Parsahm86/Car-Jack-SolidWorks/RENDERS/Car-Jack-Assem/Car-Jack-Assem_Camera_SOLIDWORKS Viewport.jpg

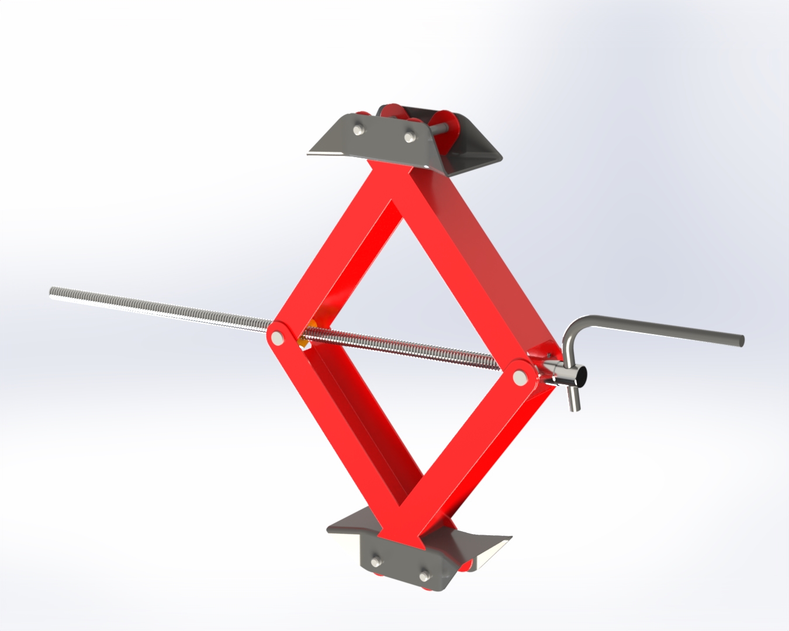
RENDERS/Car-Jack-Assem/Car-Jack-Assem_Camera_SOLIDWORKS Viewport.jpg
