Parsahm86/Car-Jack-SolidWorks/CAD/ASSEMBLY/Assem1.SLDASM

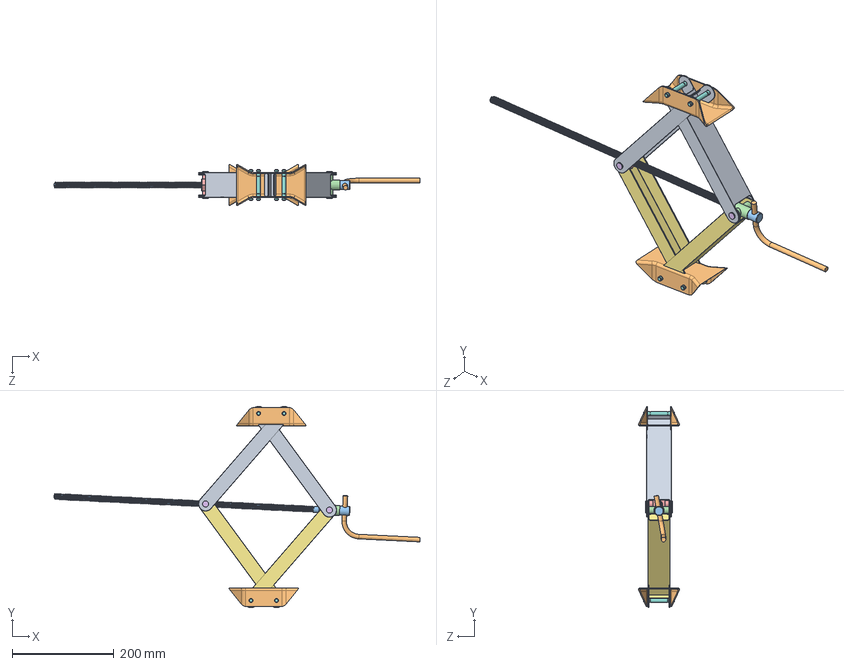
[picture p2: CAD file, 2026-08-09]
CAD/ASSEMBLY/Assem1.SLDASM
718.1 x 395.0 x 80.6 mm
Base SHeet x 2
Arm-1 x 2
Pin2 x 4
Arm-2 x 2
Pin1 x 4
Screw Nut
Screw Holder
Screw Rod
Torgue Handle
Socket set Screw x 4
