Parsahm86/Car-Jack-SolidWorks/CAD/PARTS/Pin2.SLDPRT

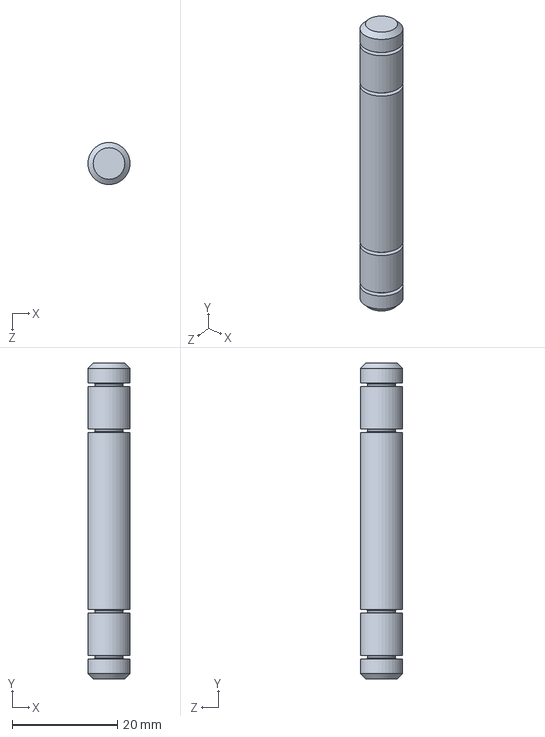
[picture p3: CAD file, 2026-08-09]
CAD/PARTS/Pin2.SLDPRT
8.00 x 60.0 x 8.00 mm
