Parsahm86/Car-Jack-SolidWorks/CAD/PARTS/Torgue Handle.SLDPRT

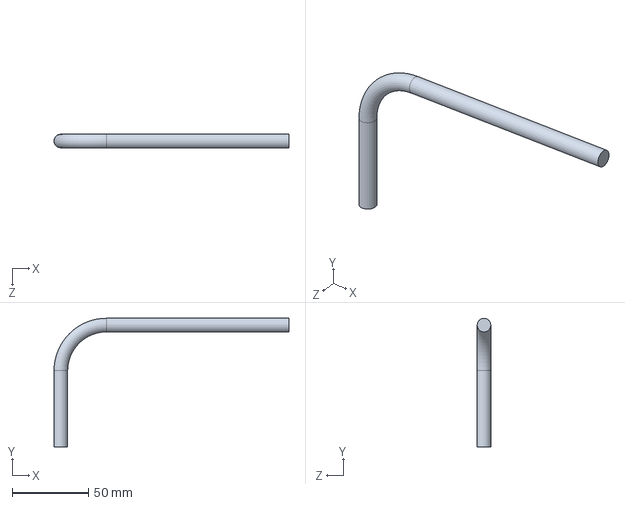
[picture p4: CAD file, 2026-08-09]
CAD/PARTS/Torgue Handle.SLDPRT
154.5 x 84.5 x 9.00 mm
