Parsahm86/Car-Jack-SolidWorks/CAD/PARTS/Pin1.SLDPRT

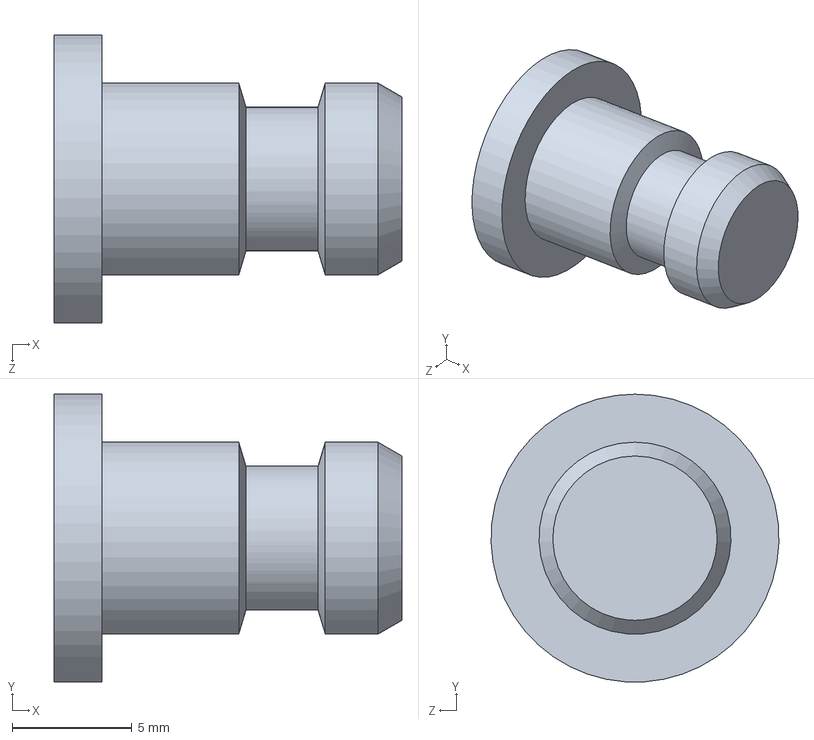
[picture p5: CAD file, 2026-08-09]
CAD/PARTS/Pin1.SLDPRT
14.5 x 12.0 x 12.0 mm
