Parsahm86/Car-Jack-SolidWorks/CAD/PARTS/Arm-2.SLDPRT

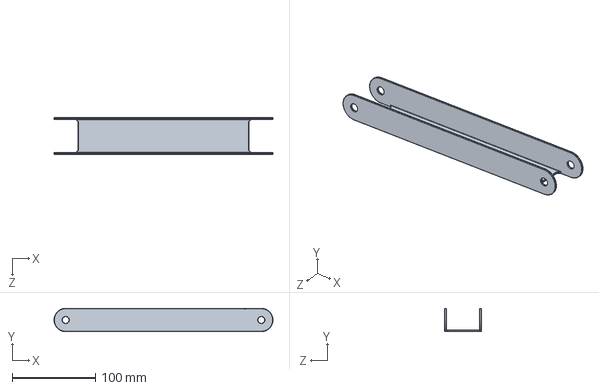
[picture p6: CAD file, 2026-08-09]
CAD/PARTS/Arm-2.SLDPRT
263.0 x 28.0 x 44.0 mm
