Parsahm86/Car-Jack-SolidWorks/CAD/PARTS/Base SHeet.SLDPRT

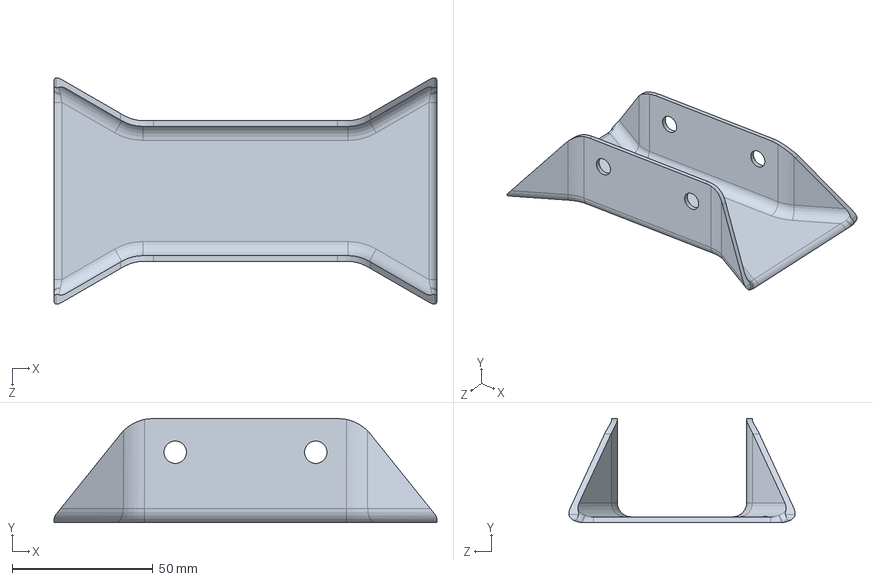
[picture p7: CAD file, 2026-08-09]
CAD/PARTS/Base SHeet.SLDPRT
136.2 x 37.0 x 80.6 mm
