Parsahm86/Car-Jack-SolidWorks/CAD/PARTS/Arm-1.SLDPRT

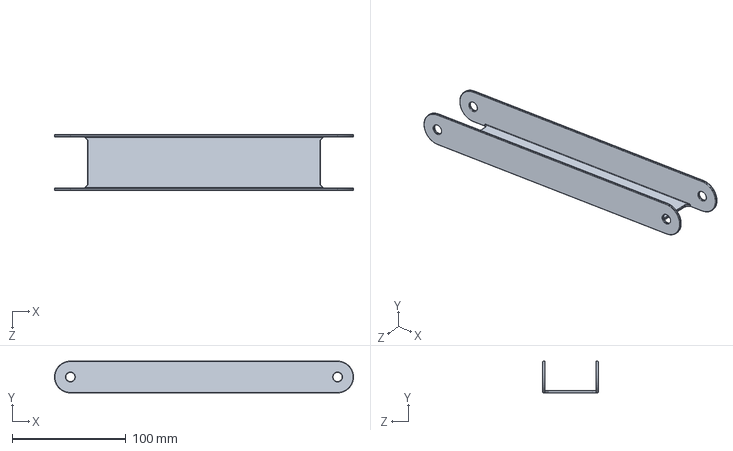
[picture p8: CAD file, 2026-08-09]
CAD/PARTS/Arm-1.SLDPRT
262.9 x 28.0 x 49.0 mm
