Parsahm86/Car-Jack-SolidWorks/CAD/PARTS/Screw Rod.SLDPRT

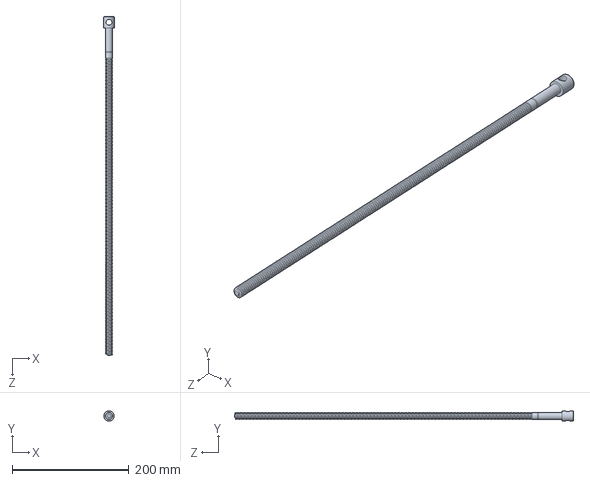
[picture p9: CAD file, 2026-08-09]
CAD/PARTS/Screw Rod.SLDPRT
18.0 x 18.0 x 581.0 mm
