Parsahm86/Car-Jack-SolidWorks/CAD/PARTS/Screw Nut.SLDPRT

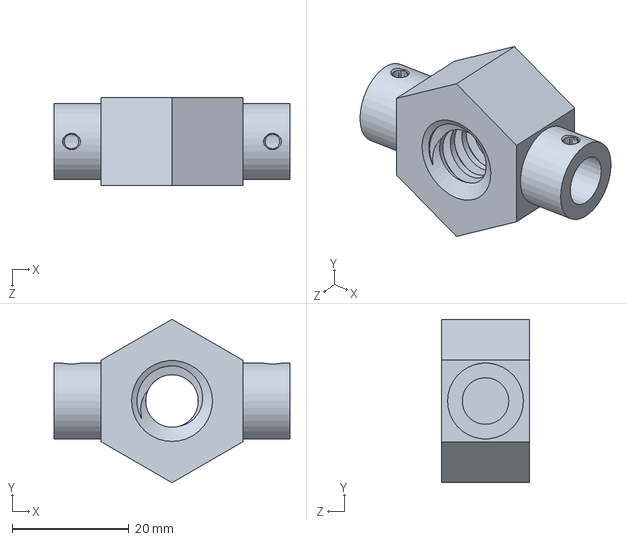
[picture p10: CAD file, 2026-08-09]
CAD/PARTS/Screw Nut.SLDPRT
40.4 x 28.0 x 15.0 mm
