Parsahm86/Car-Jack-SolidWorks/CAD/PARTS/Socket set Screw.SLDPRT

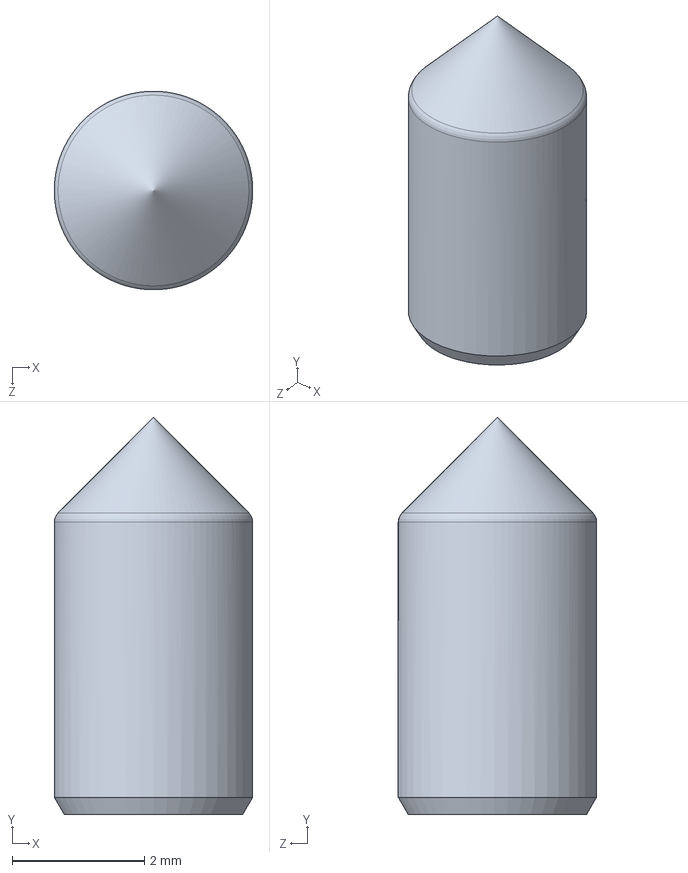
[picture p11: CAD file, 2026-08-09]
CAD/PARTS/Socket set Screw.SLDPRT
3.00 x 6.00 x 3.00 mm
