Parsahm86/Car-Jack-SolidWorks/CAD/PARTS/Screw Holder.SLDPRT

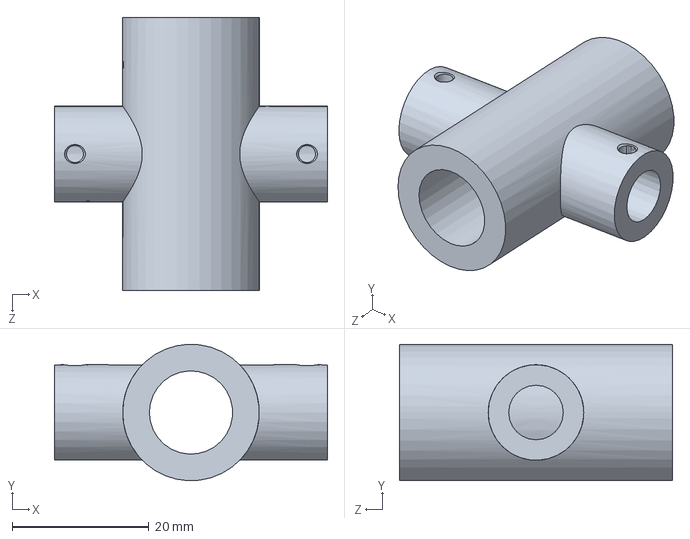
[picture p12: CAD file, 2026-08-09]
CAD/PARTS/Screw Holder.SLDPRT
40.0 x 20.0 x 40.0 mm
