Parsahm86/Car-Jack-SolidWorks/DRAWING FILES/Drawing file PDF.pdf

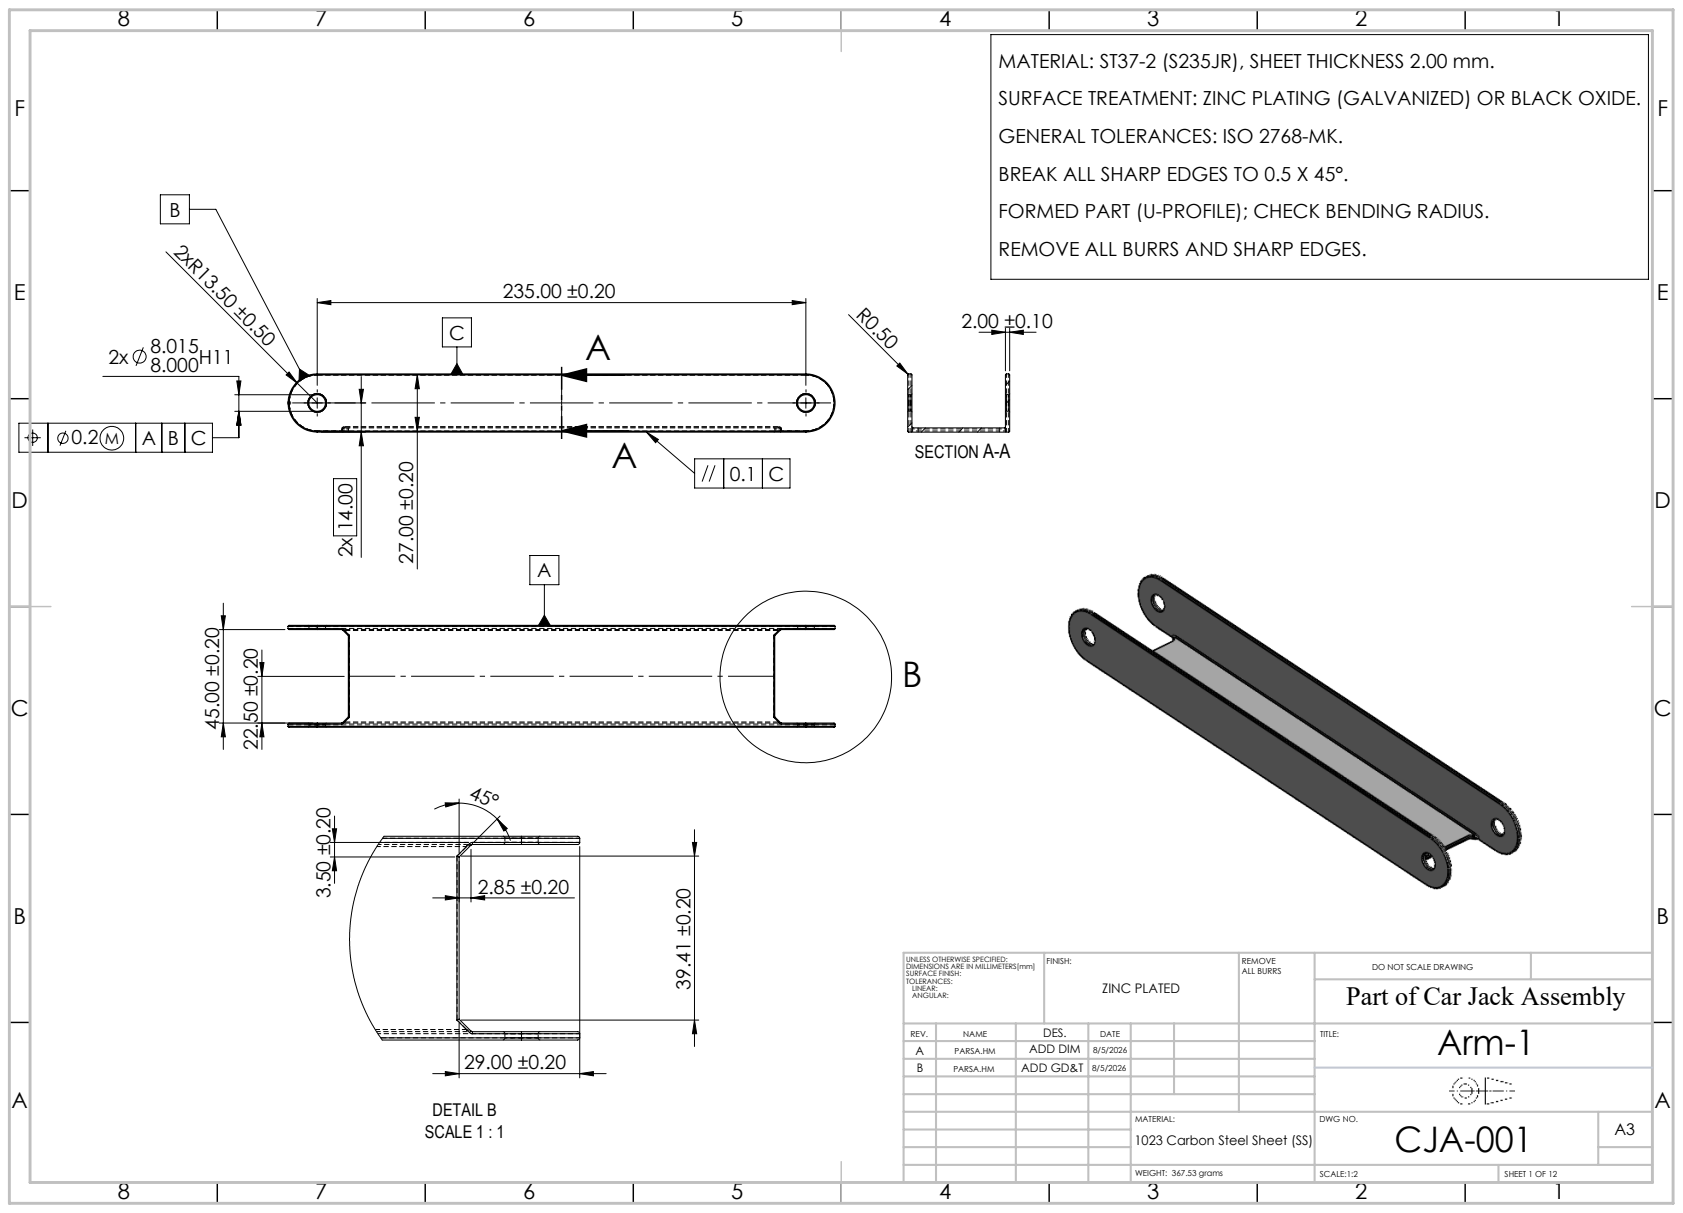
[picture p13: page 1]
SECTION A-A; DETAIL B SCALE 1 : 1; ALL BURRS; ZINC PLATED

MATERIAL: ST37-2 (S235JR), SHEET THICKNESS 2.00 mm.
SURFACE TREATMENT: ZINC PLATING (GALVANIZED) OR BLACK OXIDE.
GENERAL TOLERANCES: ISO 2768-MK.
BREAK ALL SHARP EDGES TO 0.5 X 45°.
FORMED PART (U-PROFILE); CHECK BENDING RADIUS.
REMOVE ALL BURRS AND SHARP EDGES.

UNLESS OTHERWISE SPECIFIED:
DIMENSIONS ARE IN MILLIMETERS[mm]
SURFACE FINISH:
TOLERANCES:
LINEAR:
ANGULAR:

DO NOT SCALE DRAWING
Part of Car Jack Assembly

NAME | DES. | DATE | Arm-1 REV. TITLE:
A | PARSA.HM | ADD DIM | 8/5/2026
B | PARSA.HM | ADD GD&T | 8/5/2026

MATERIAL: | DWG NO. CJA-001 | A3 1023 Carbon Steel Sheet (SS)

WEIGHT: 367.53 grams | SCALE:1:2 | SHEET 1 OF 12

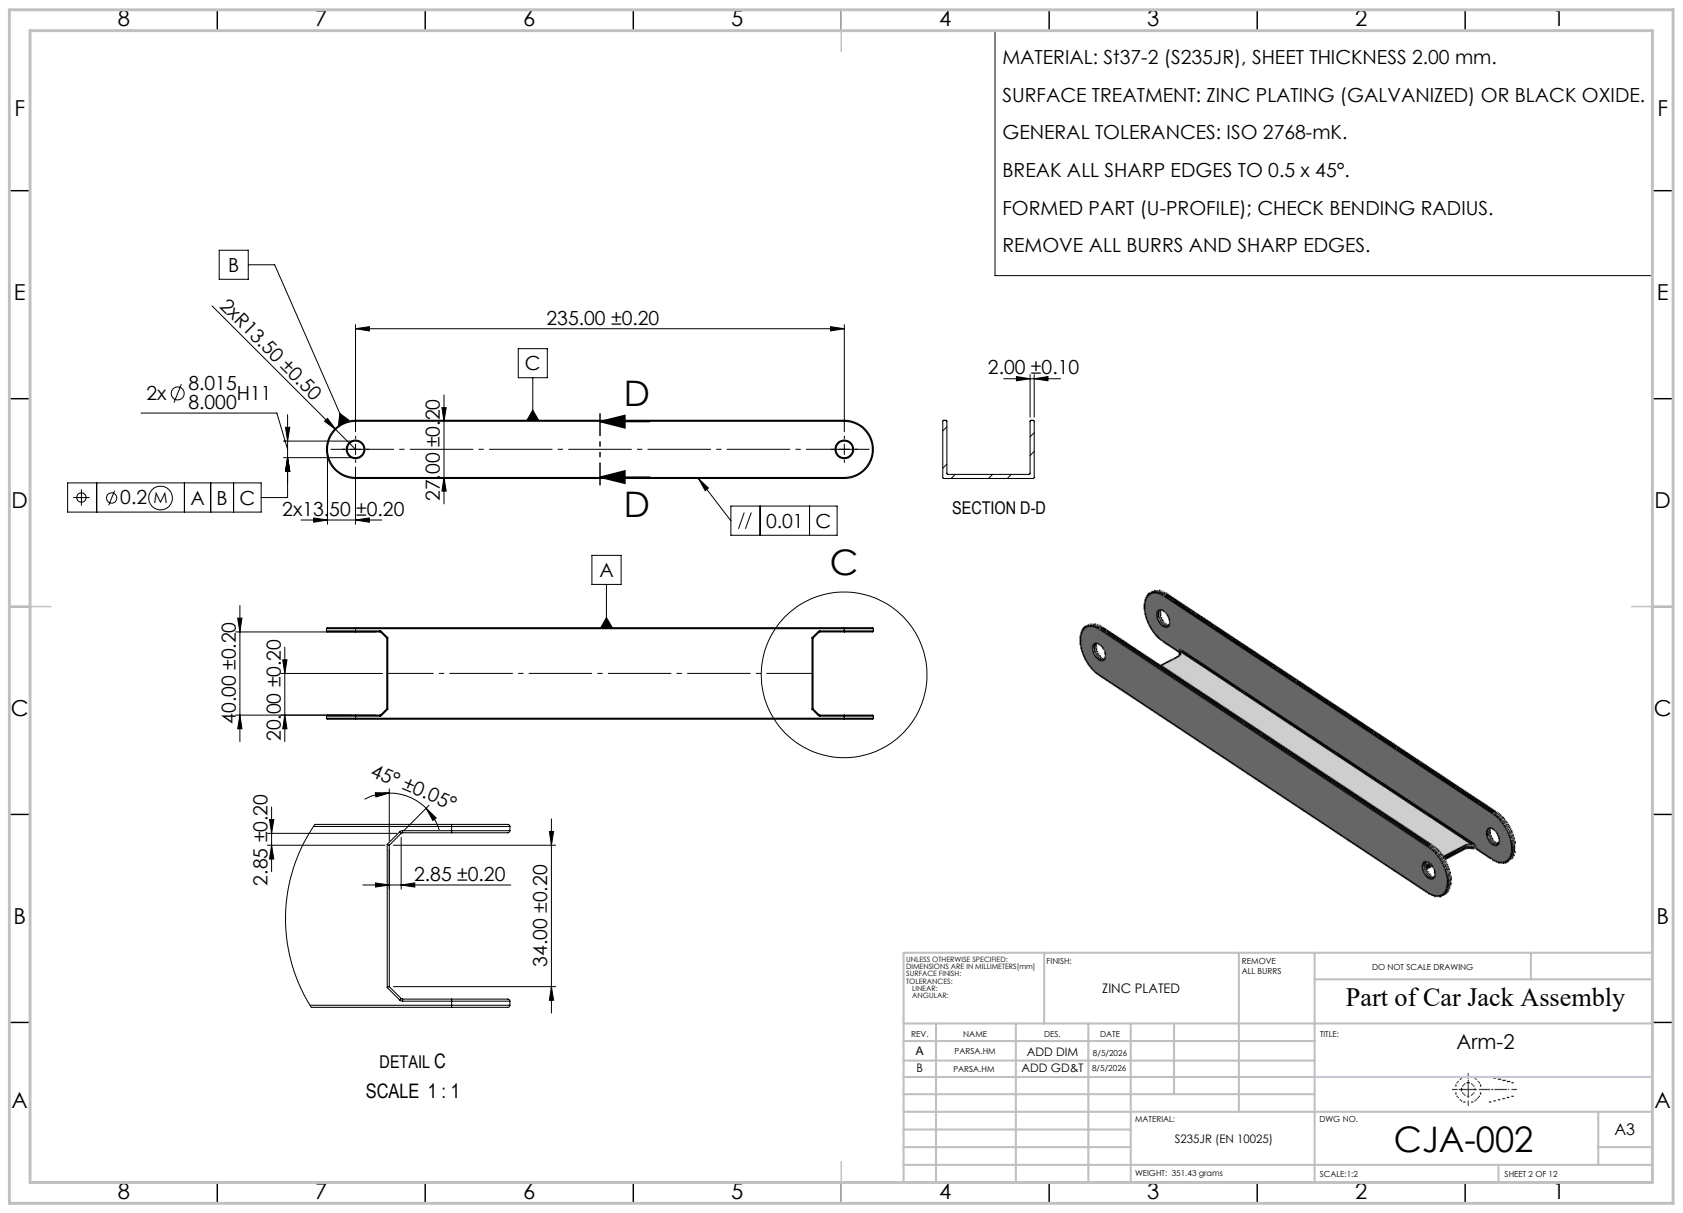
[picture p14: page 2]
DETAIL C SCALE 1 : 1; SECTION D-D; ALL BURRS; ZINC PLATED

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

UNLESS OTHERWISE SPECIFIED:
DIMENSIONS ARE IN MILLIMETERS[mm]
SURFACE FINISH:
TOLERANCES:
LINEAR:
ANGULAR:

DO NOT SCALE DRAWING
Part of Car Jack Assembly

NAME | DES. | DATE | TITLE: Arm-2 REV.
A | PARSA.HM | ADD DIM | 8/5/2026
B | PARSA.HM | ADD GD&T | 8/5/2026

CJA-002 | A3 S235JR (EN 10025)

WEIGHT: 351.43 grams | SCALE:1:2 | SHEET 2 OF 12

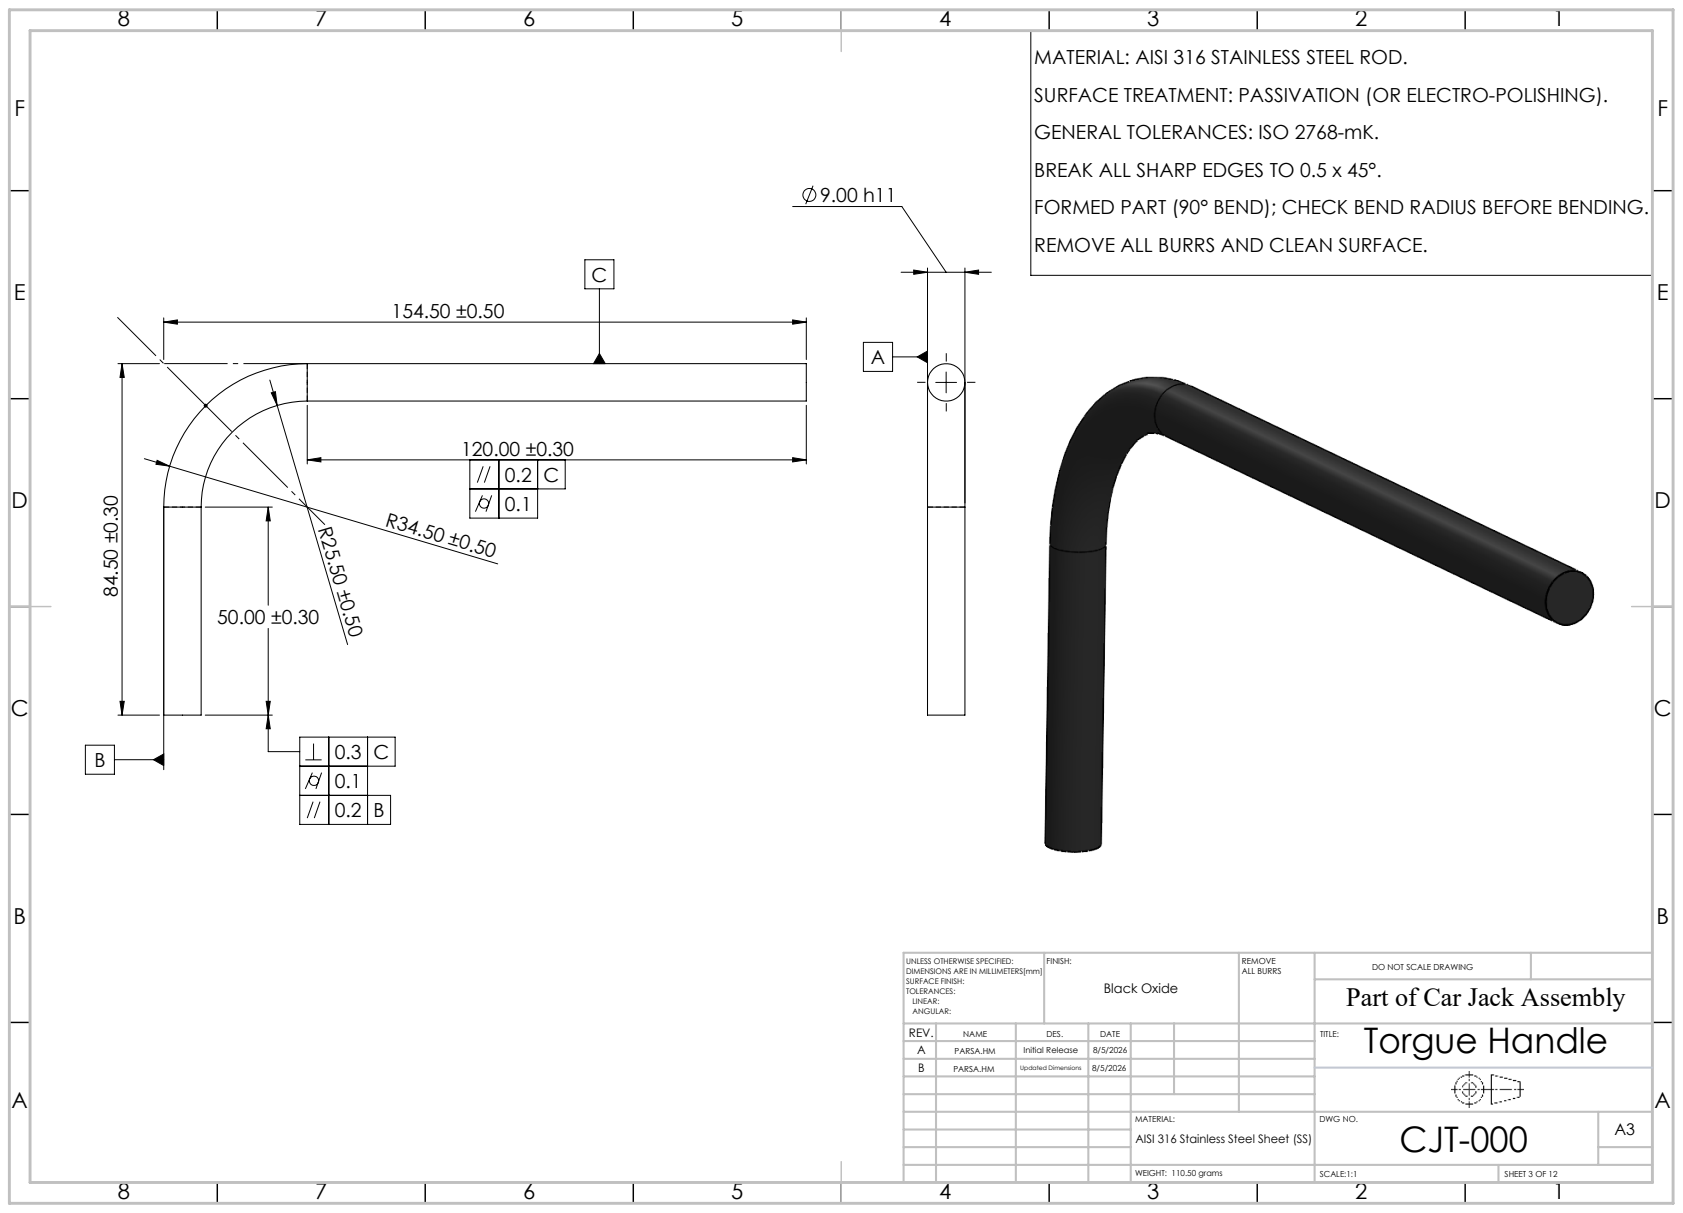
[picture p15: page 3]
ALL BURRS; Black Oxide

MATERIAL: AISI 316 STAINLESS STEEL ROD.
SURFACE TREATMENT: PASSIVATION (OR ELECTRO-POLISHING).
GENERAL TOLERANCES: ISO 2768-mK.
BREAK ALL SHARP EDGES TO 0.5 x 45°.
FORMED PART (90° BEND); CHECK BEND RADIUS BEFORE BENDING.
REMOVE ALL BURRS AND CLEAN SURFACE.

UNLESS OTHERWISE SPECIFIED:
DIMENSIONS ARE IN MILLIMETERS[mm]
SURFACE FINISH:
TOLERANCES:
LINEAR:
ANGULAR:

DO NOT SCALE DRAWING
Part of Car Jack Assembly

NAME | DES. | DATE | Torgue Handle REV. TITLE:
A | PARSA.HM | Initial Release | 8/5/2026
B | PARSA.HM | Updated Dimensions | 8/5/2026

CJT-000 | A3 AISI 316 Stainless Steel Sheet (SS)

WEIGHT: 110.50 grams | SCALE:1:1 | SHEET 3 OF 12

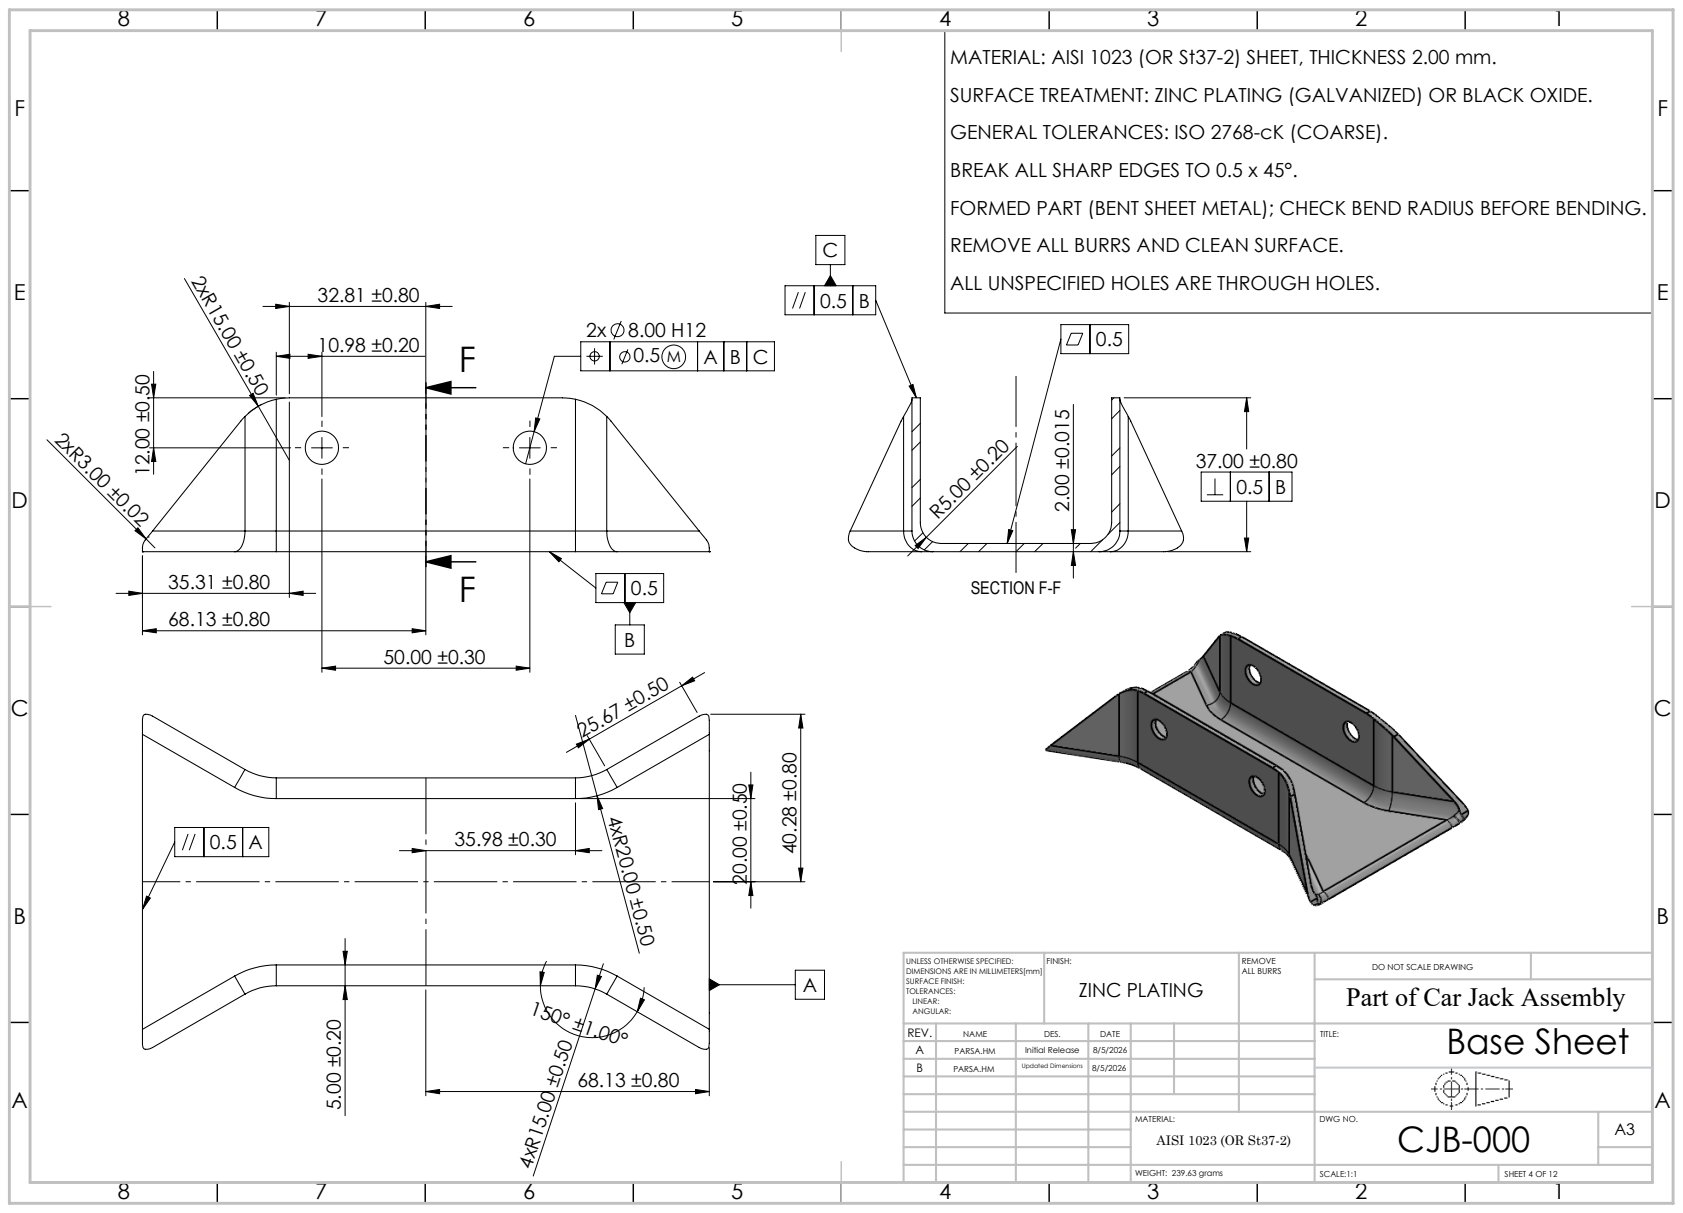
[picture p16: page 4]
SECTION F-F; ALL BURRS; ZINC PLATING

MATERIAL: AISI 1023 (OR St37-2) SHEET, THICKNESS 2.00 mm.
SURFACE TREATMENT: ZINC PLATING (GALVANIZED) OR BLACK OXIDE.
GENERAL TOLERANCES: ISO 2768-cK (COARSE).
BREAK ALL SHARP EDGES TO 0.5 x 45°.
FORMED PART (BENT SHEET METAL); CHECK BEND RADIUS BEFORE BENDING.
REMOVE ALL BURRS AND CLEAN SURFACE.
ALL UNSPECIFIED HOLES ARE THROUGH HOLES.

UNLESS OTHERWISE SPECIFIED:
DIMENSIONS ARE IN MILLIMETERS[mm]
SURFACE FINISH:
TOLERANCES:
LINEAR:
ANGULAR:

DO NOT SCALE DRAWING
Part of Car Jack Assembly

NAME | Initial Release DES. | DATE | Base Sheet REV. TITLE:
A | PARSA.HM | | 8/5/2026
B | PARSA.HM | Updated Dimensions | 8/5/2026

CJB-000 | A3 AISI 1023 (OR St37-2)

WEIGHT: 239.63 grams | SCALE:1:1 | SHEET 4 OF 12

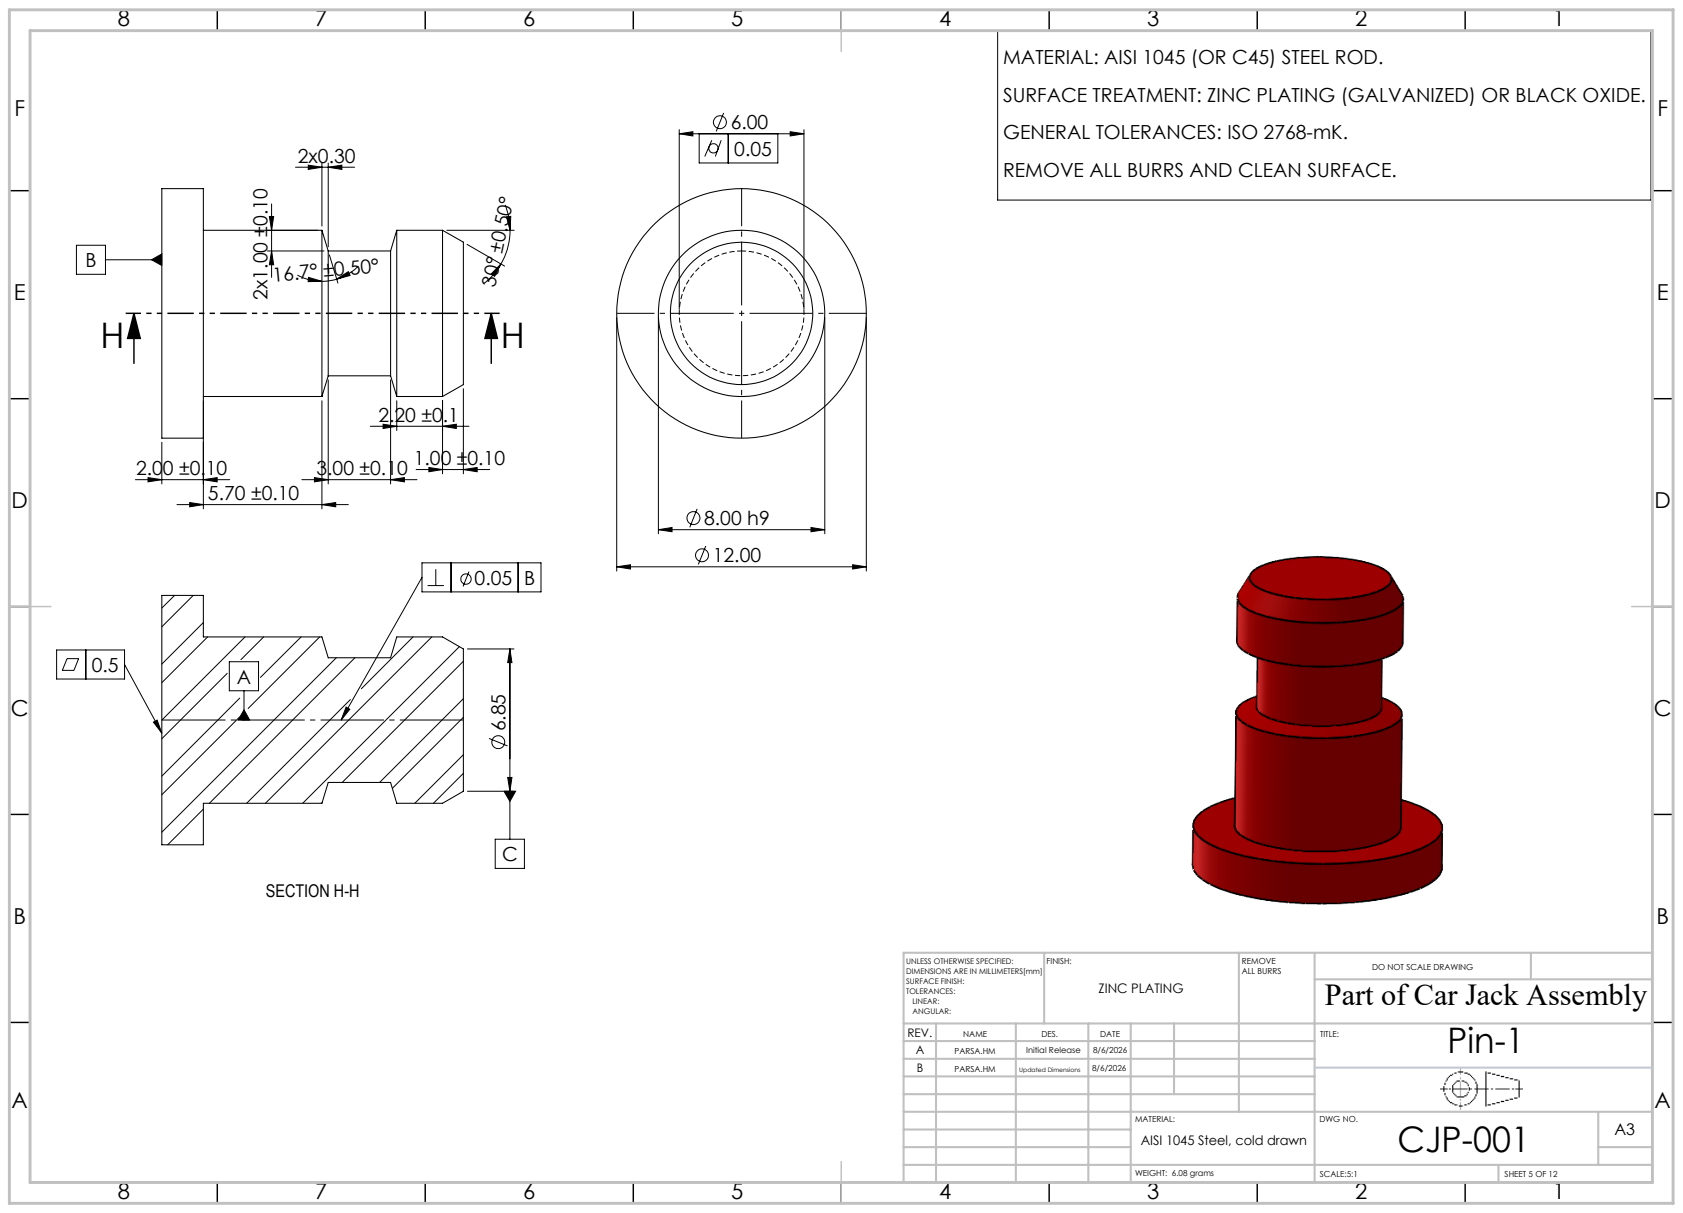
[picture p17: page 5]
SECTION H-H; ALL BURRS; ZINC PLATING

MATERIAL: AISI 1045 (OR C45) STEEL ROD.
SURFACE TREATMENT: ZINC PLATING (GALVANIZED) OR BLACK OXIDE.
GENERAL TOLERANCES: ISO 2768-mK.
REMOVE ALL BURRS AND CLEAN SURFACE.

UNLESS OTHERWISE SPECIFIED:
DIMENSIONS ARE IN MILLIMETERS[mm]
SURFACE FINISH:
TOLERANCES:
LINEAR:
ANGULAR:

DO NOT SCALE DRAWING
Part of Car Jack Assembly

NAME | DES. | DATE | Pin-1 REV. TITLE:
A | PARSA.HM | Initial Release | 8/6/2026
B | PARSA.HM | Updated Dimensions | 8/6/2026

CJP-001 | A3 AISI 1045 Steel, cold drawn

WEIGHT: 6.08 grams | SCALE:5:1 | SHEET 5 OF 12

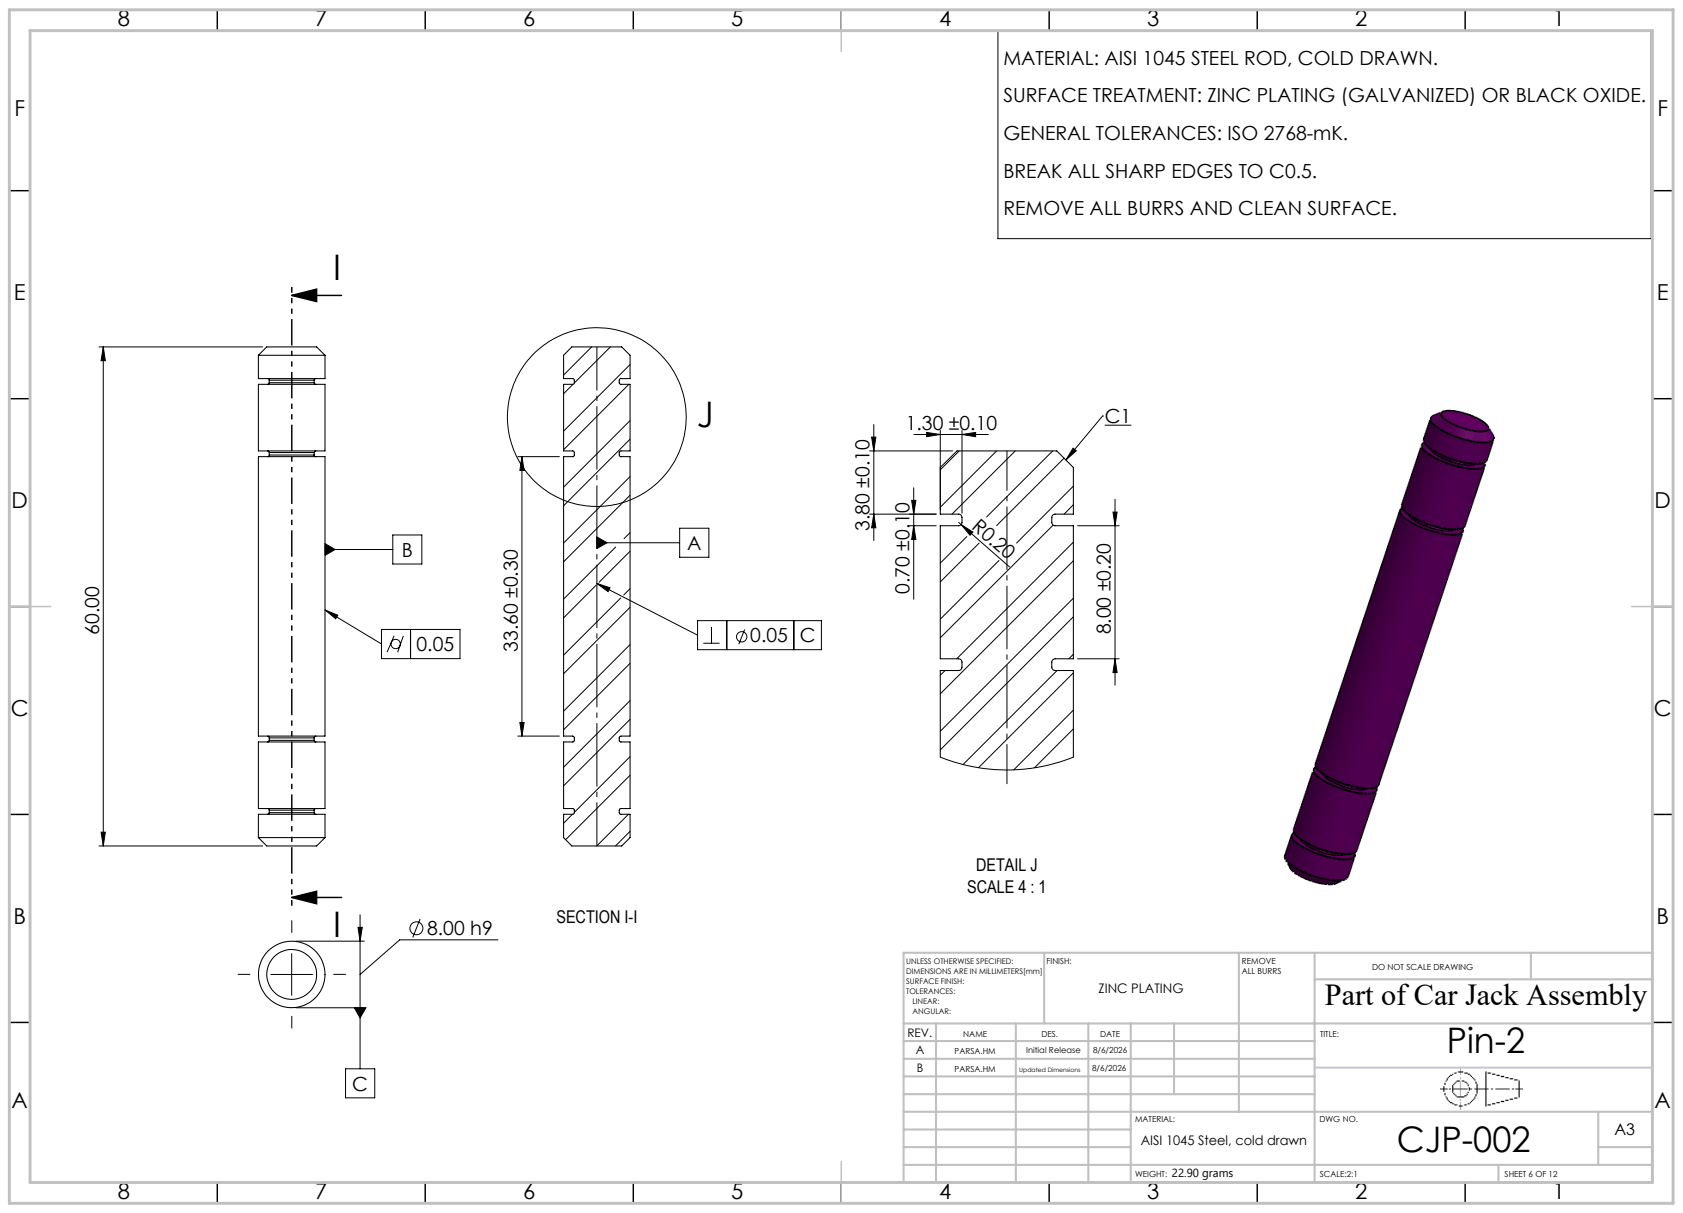
[picture p18: page 6]
SECTION I-I; DETAIL J SCALE 4 : 1; ALL BURRS; ZINC PLATING

MATERIAL: AISI 1045 STEEL ROD, COLD DRAWN.
SURFACE TREATMENT: ZINC PLATING (GALVANIZED) OR BLACK OXIDE.
GENERAL TOLERANCES: ISO 2768-mK.
BREAK ALL SHARP EDGES TO C0.5.
REMOVE ALL BURRS AND CLEAN SURFACE.

UNLESS OTHERWISE SPECIFIED:
DIMENSIONS ARE IN MILLIMETERS[mm]
SURFACE FINISH:
TOLERANCES:
LINEAR:
ANGULAR:

DO NOT SCALE DRAWING
Part of Car Jack Assembly

NAME | DES. | DATE | Pin-2 REV. TITLE:
A | PARSA.HM | Initial Release | 8/6/2026
B | PARSA.HM | Updated Dimensions | 8/6/2026

CJP-002

WEIGHT: 22.90 grams | SCALE:2:1 | SHEET 6 OF 12

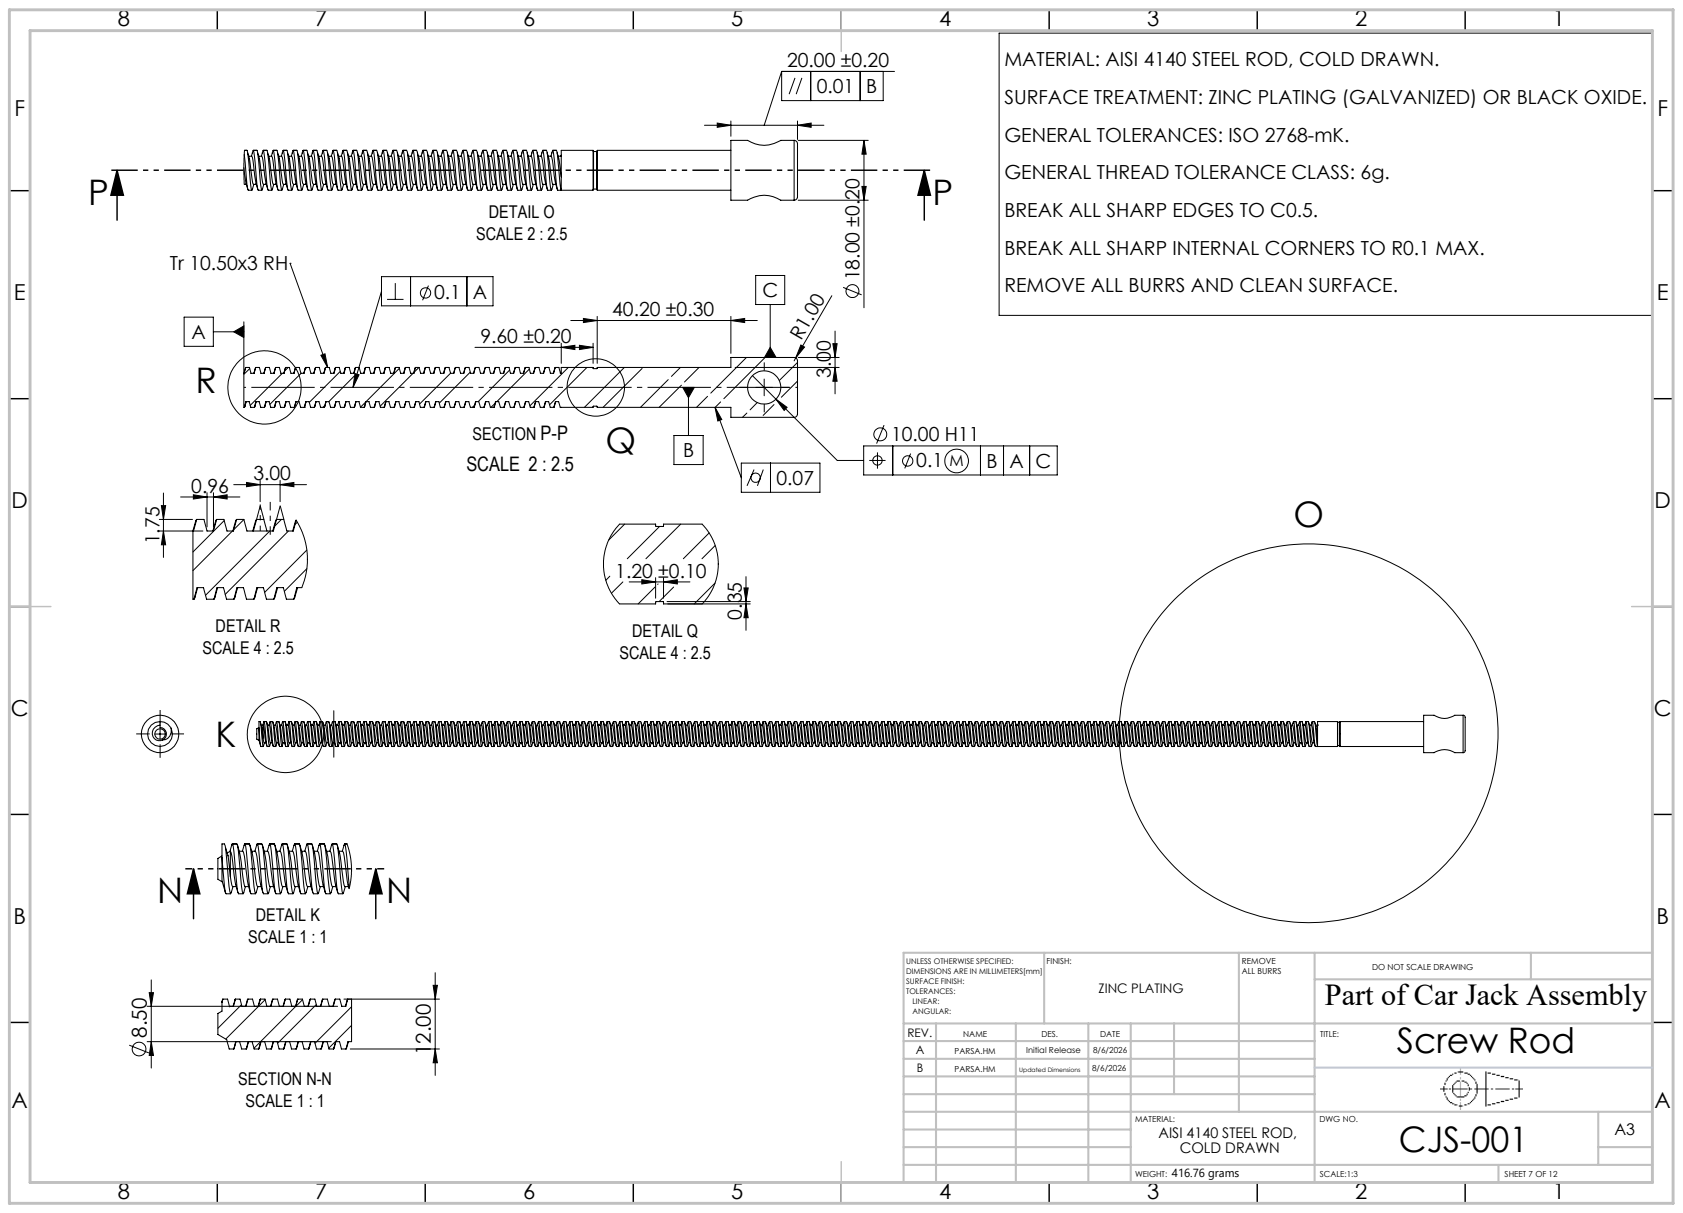
[picture p19: page 7]
DETAIL K SCALE 1 : 1; SECTION N-N SCALE 1 : 1; DETAIL O SCALE 2 : 2.5; SECTION P-P SCALE 2 : 2.5; DETAIL Q SCALE 4 : 2.5; DETAIL R SCALE 4 : 2.5; ALL BURRS; SCALE:1:3; SHEET 7 OF 12; AISI 4140 STEEL ROD,; COLD DRAWN; ZINC PLATING; WEIGHT: 416.76 grams; Initial Release; Updated Dimensions

MATERIAL: AISI 4140 STEEL ROD, COLD DRAWN.

SURFACE TREATMENT: ZINC PLATING (GALVANIZED) OR BLACK OXIDE.
GENERAL TOLERANCES: ISO 2768-mK.
GENERAL THREAD TOLERANCE CLASS: 6g.
BREAK ALL SHARP EDGES TO C0.5.
BREAK ALL SHARP INTERNAL CORNERS TO R0.1 MAX.
REMOVE ALL BURRS AND CLEAN SURFACE.

UNLESS OTHERWISE SPECIFIED:
DIMENSIONS ARE IN MILLIMETERS[mm]
SURFACE FINISH:
TOLERANCES:
LINEAR:
ANGULAR:
Screw Rod REV.

DO NOT SCALE DRAWING
Part of Car Jack Assembly

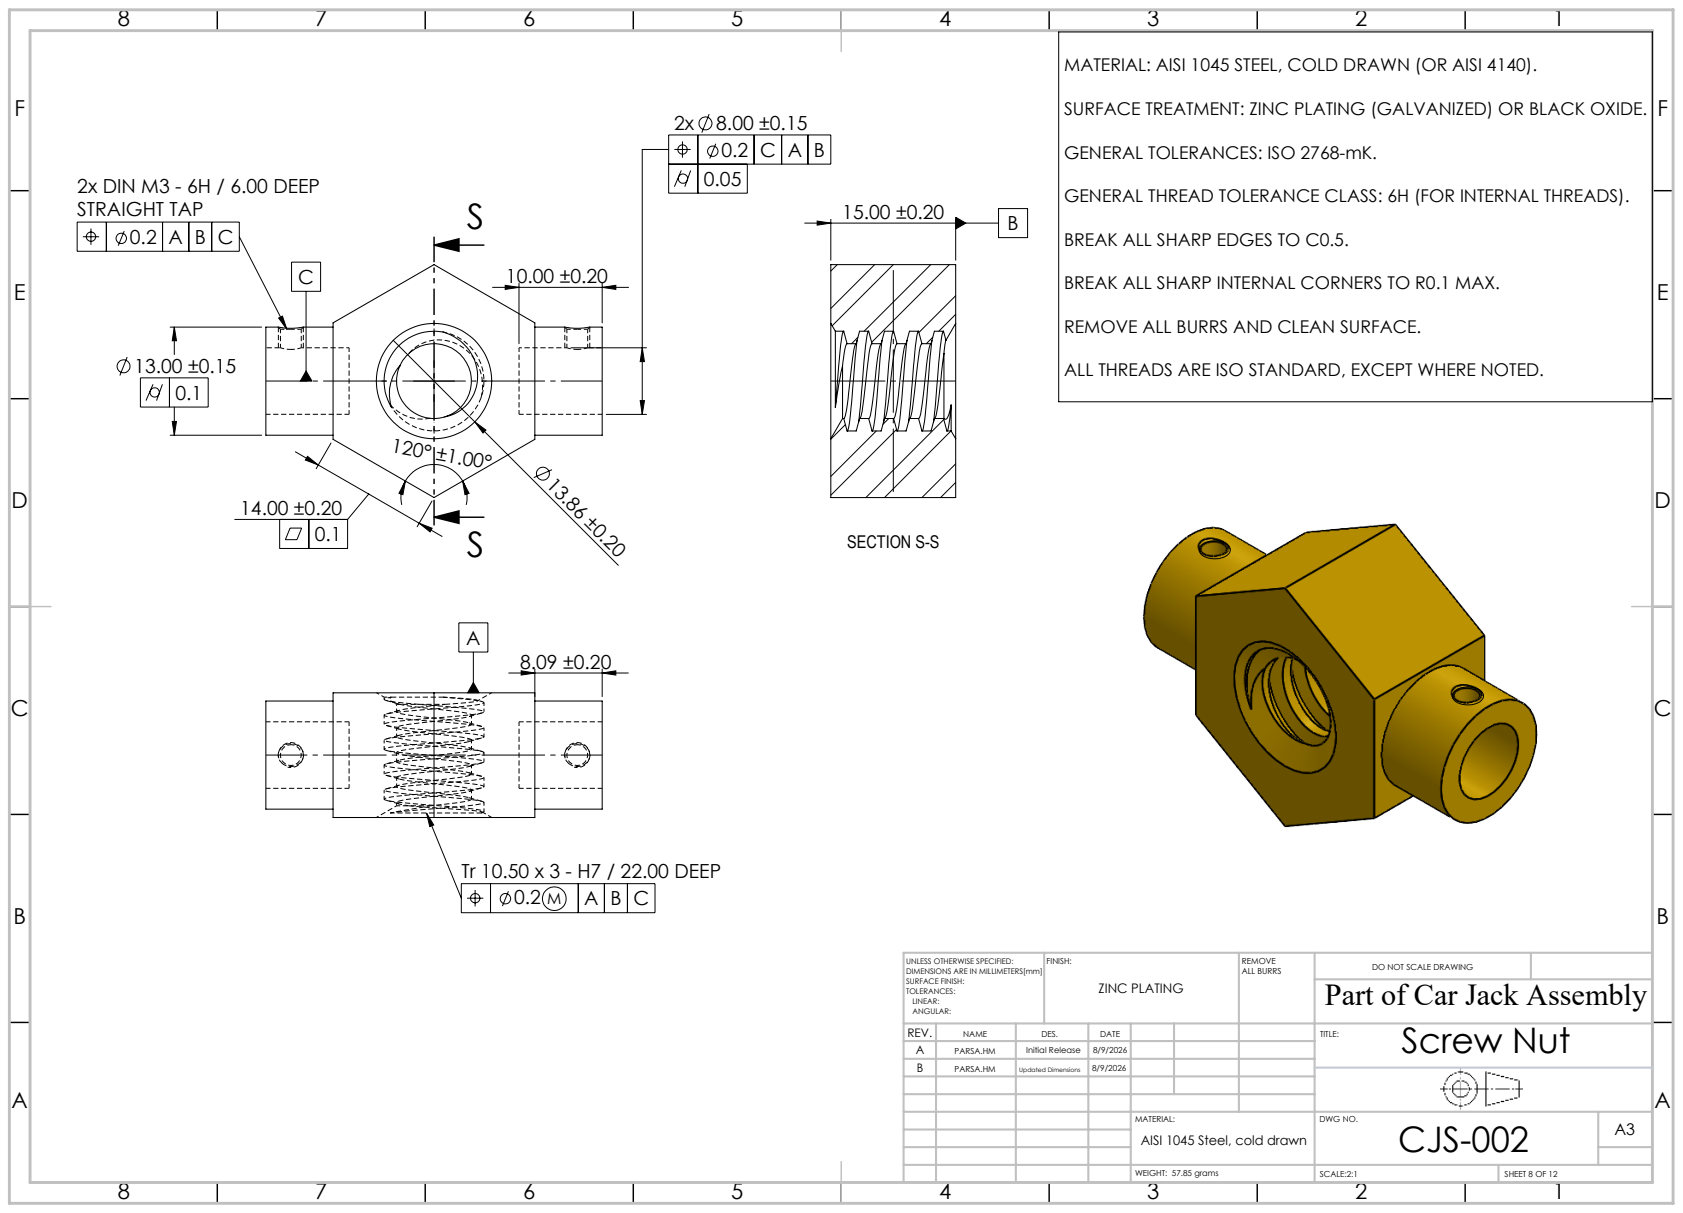
[picture p20: page 8]
2x DIN M3 - 6H / 6.00 DEEP STRAIGHT TAP; Tr 10.50 x 3 - H7 / 22.00 DEEP; SECTION S-S; ALL BURRS; ZINC PLATING

MATERIAL: AISI 1045 STEEL, COLD DRAWN (OR AISI 4140).
SURFACE TREATMENT: ZINC PLATING (GALVANIZED) OR BLACK OXIDE.
GENERAL TOLERANCES: ISO 2768-mK.
GENERAL THREAD TOLERANCE CLASS: 6H (FOR INTERNAL THREADS).
BREAK ALL SHARP EDGES TO C0.5.
BREAK ALL SHARP INTERNAL CORNERS TO R0.1 MAX.
REMOVE ALL BURRS AND CLEAN SURFACE.
ALL THREADS ARE ISO STANDARD, EXCEPT WHERE NOTED.

UNLESS OTHERWISE SPECIFIED:
DIMENSIONS ARE IN MILLIMETERS[mm]
SURFACE FINISH:
TOLERANCES:
LINEAR:
ANGULAR:

DO NOT SCALE DRAWING
Part of Car Jack Assembly

NAME | DES. | DATE | Screw Nut REV. TITLE:
A | PARSA.HM | Initial Release | 8/9/2026
B | PARSA.HM | Updated Dimensions | 8/9/2026

CJS-002

WEIGHT: 57.85 grams | SCALE:2:1 | SHEET 8 OF 12

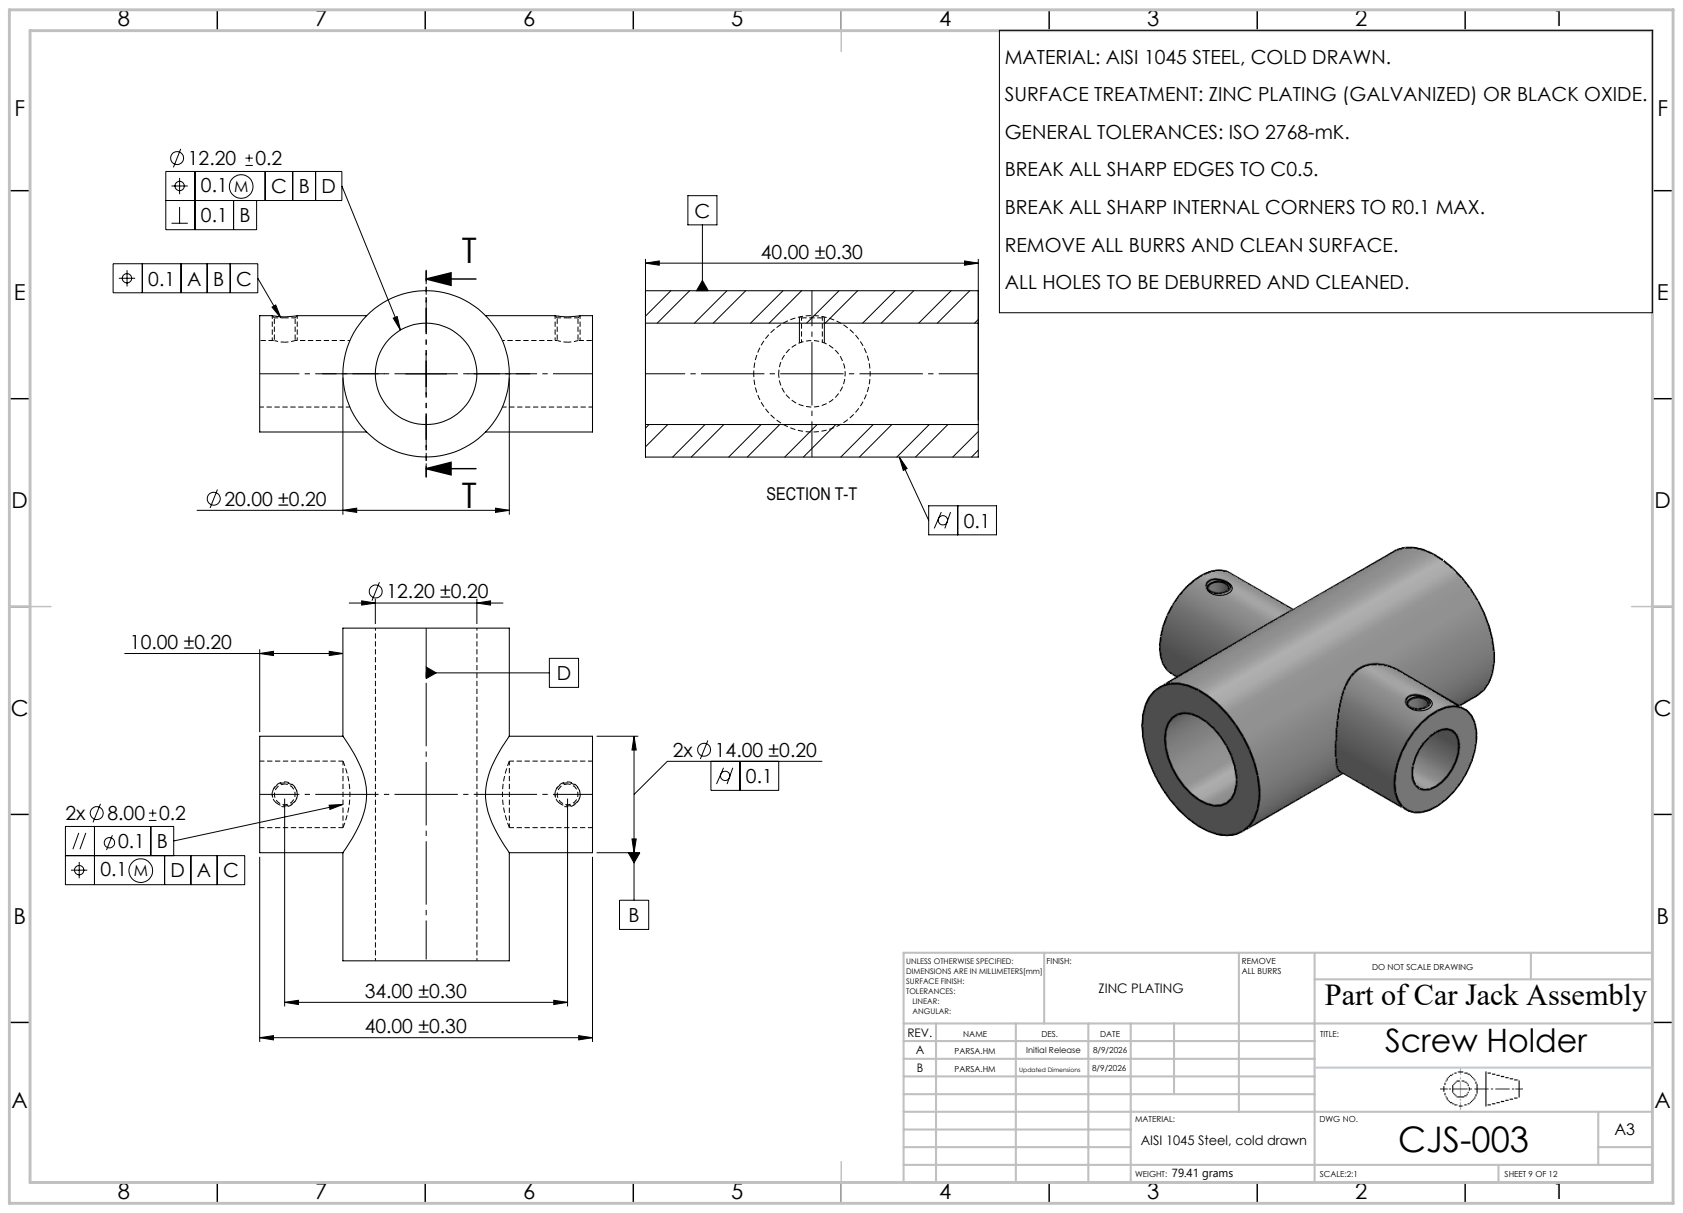
[picture p21: page 9]
SECTION T-T; ALL BURRS; ZINC PLATING

MATERIAL: AISI 1045 STEEL, COLD DRAWN.
SURFACE TREATMENT: ZINC PLATING (GALVANIZED) OR BLACK OXIDE.
GENERAL TOLERANCES: ISO 2768-mK.
BREAK ALL SHARP EDGES TO C0.5.
BREAK ALL SHARP INTERNAL CORNERS TO R0.1 MAX.
REMOVE ALL BURRS AND CLEAN SURFACE.
ALL HOLES TO BE DEBURRED AND CLEANED.

UNLESS OTHERWISE SPECIFIED:
DIMENSIONS ARE IN MILLIMETERS[mm]
SURFACE FINISH:
TOLERANCES:
LINEAR:
ANGULAR:

DO NOT SCALE DRAWING
Part of Car Jack Assembly

NAME | DES. | DATE | Screw Holder REV. TITLE:
A | PARSA.HM | Initial Release | 8/9/2026
B | PARSA.HM | Updated Dimensions | 8/9/2026

CJS-003

WEIGHT: 79.41 grams | SCALE:2:1 | SHEET 9 OF 12

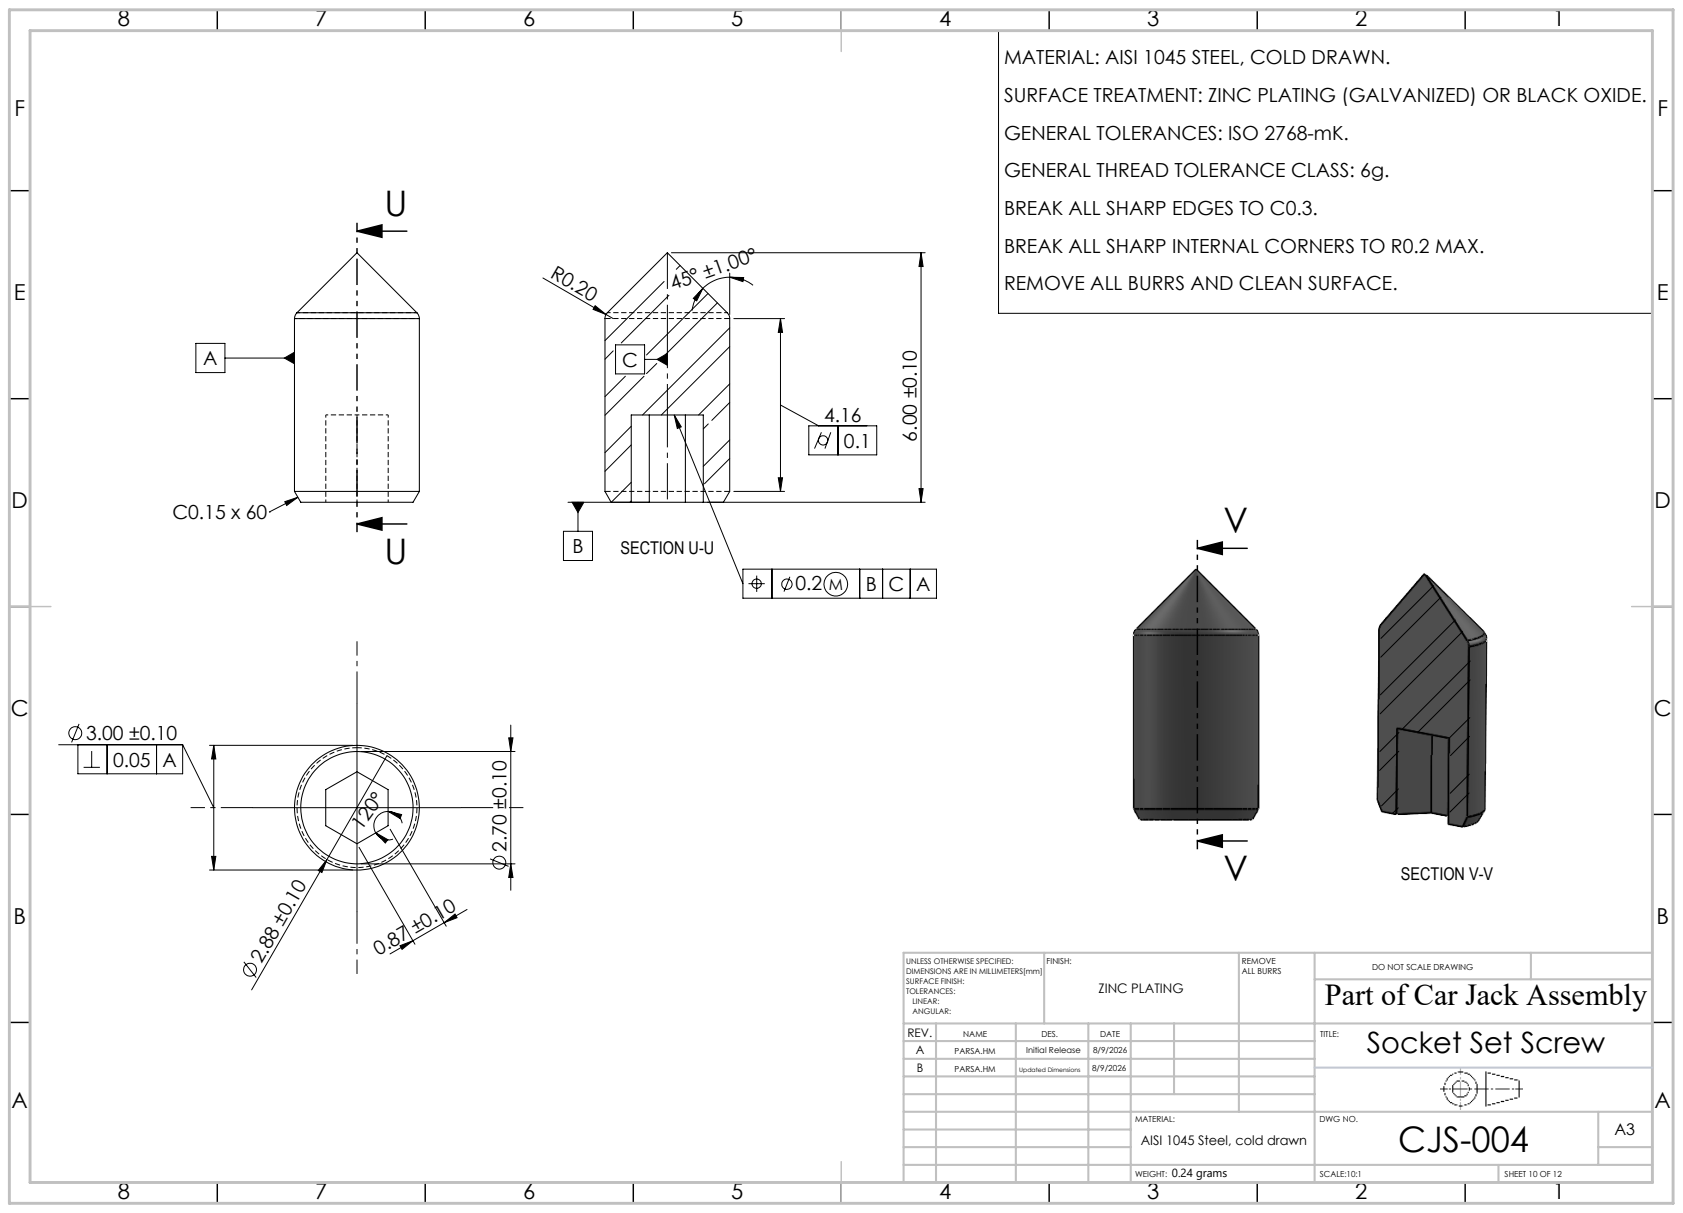
[picture p22: page 10]
SECTION U-U; SECTION V-V; ALL BURRS; ZINC PLATING

MATERIAL: AISI 1045 STEEL, COLD DRAWN.
SURFACE TREATMENT: ZINC PLATING (GALVANIZED) OR BLACK OXIDE.
GENERAL TOLERANCES: ISO 2768-mK.
GENERAL THREAD TOLERANCE CLASS: 6g.
BREAK ALL SHARP EDGES TO C0.3.
BREAK ALL SHARP INTERNAL CORNERS TO R0.2 MAX.
REMOVE ALL BURRS AND CLEAN SURFACE.

UNLESS OTHERWISE SPECIFIED:
DIMENSIONS ARE IN MILLIMETERS[mm]
SURFACE FINISH:
TOLERANCES:
LINEAR:
ANGULAR:

DO NOT SCALE DRAWING
Part of Car Jack Assembly

NAME | DES. | DATE | Socket Set Screw REV. TITLE:
A | PARSA.HM | Initial Release | 8/9/2026
B | PARSA.HM | Updated Dimensions | 8/9/2026

CJS-004

WEIGHT: 0.24 grams | SCALE:10:1 | SHEET 10 OF 12

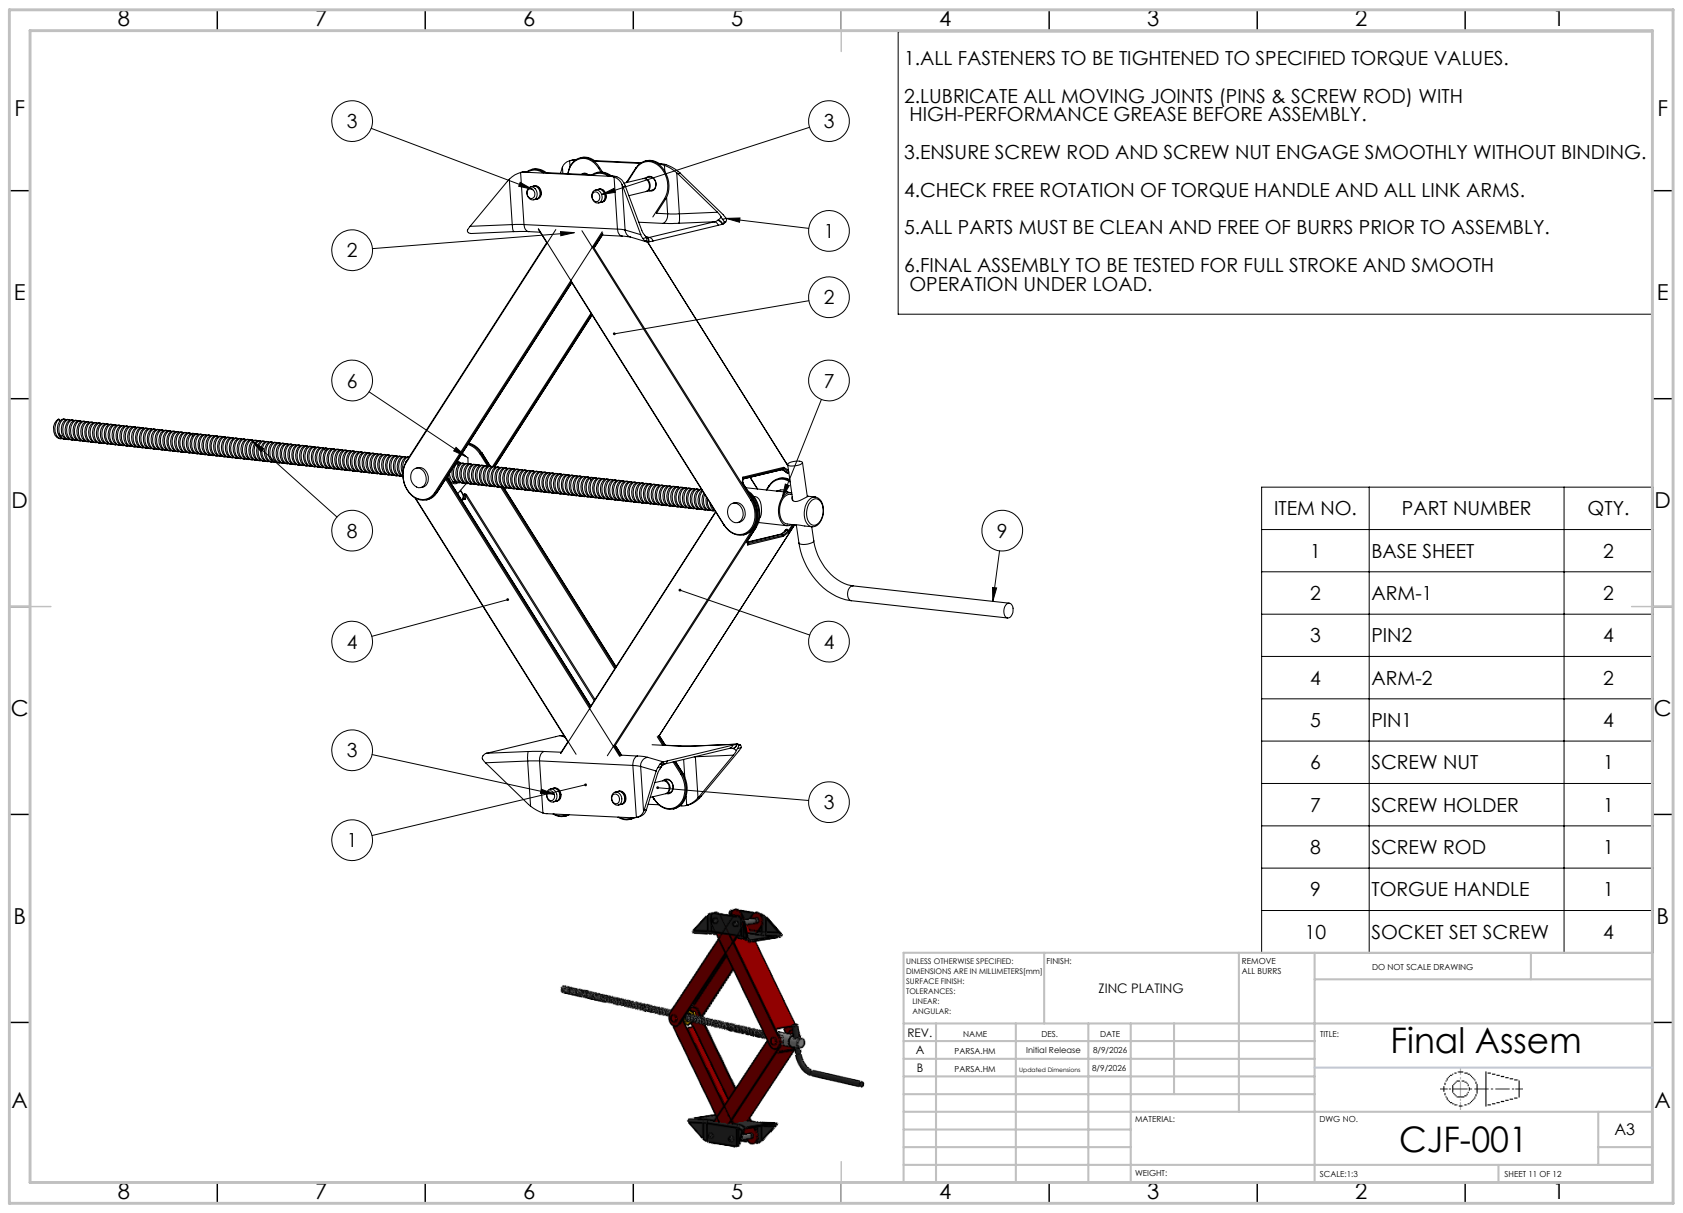
[picture p23: page 11]
SCALE:1:3; SHEET 11 OF 12

1.ALL FASTENERS TO BE TIGHTENED TO SPECIFIED TORQUE VALUES.
2.LUBRICATE ALL MOVING JOINTS (PINS & SCREW ROD) WITH
HIGH-PERFORMANCE GREASE BEFORE ASSEMBLY.
3.ENSURE SCREW ROD AND SCREW NUT ENGAGE SMOOTHLY WITHOUT BINDING.
4.CHECK FREE ROTATION OF TORQUE HANDLE AND ALL LINK ARMS.
5.ALL PARTS MUST BE CLEAN AND FREE OF BURRS PRIOR TO ASSEMBLY.
6.FINAL ASSEMBLY TO BE TESTED FOR FULL STROKE AND SMOOTH
OPERATION UNDER LOAD.

ITEM NO. | PART NUMBER | QTY.
1 | BASE SHEET | 2
2 | ARM-1 | 2
3 | PIN2 | 4
4 | ARM-2 | 2
5 | PIN1 | 4
6 | SCREW NUT | 1
7 | SCREW HOLDER | 1
8 | SCREW ROD | 1
9 | TORGUE HANDLE | 1
10 | SOCKET SET SCREW | 4

UNLESS OTHERWISE SPECIFIED: DIMENSIONS ARE IN MILLIMETERS[mm] SURFACE FINISH: TOLERANCES: LINEAR: ANGULAR: | FINISH: ZINC PLATING | REMOVE ALL BURRS | DO NOT SCALE DRAWING

REV. | NAME | Initial Release DES. | DATE | Final Assem Updated Dimensions TITLE:
A | PARSA.HM | | 8/9/2026
B | PARSA.HM | | 8/9/2026

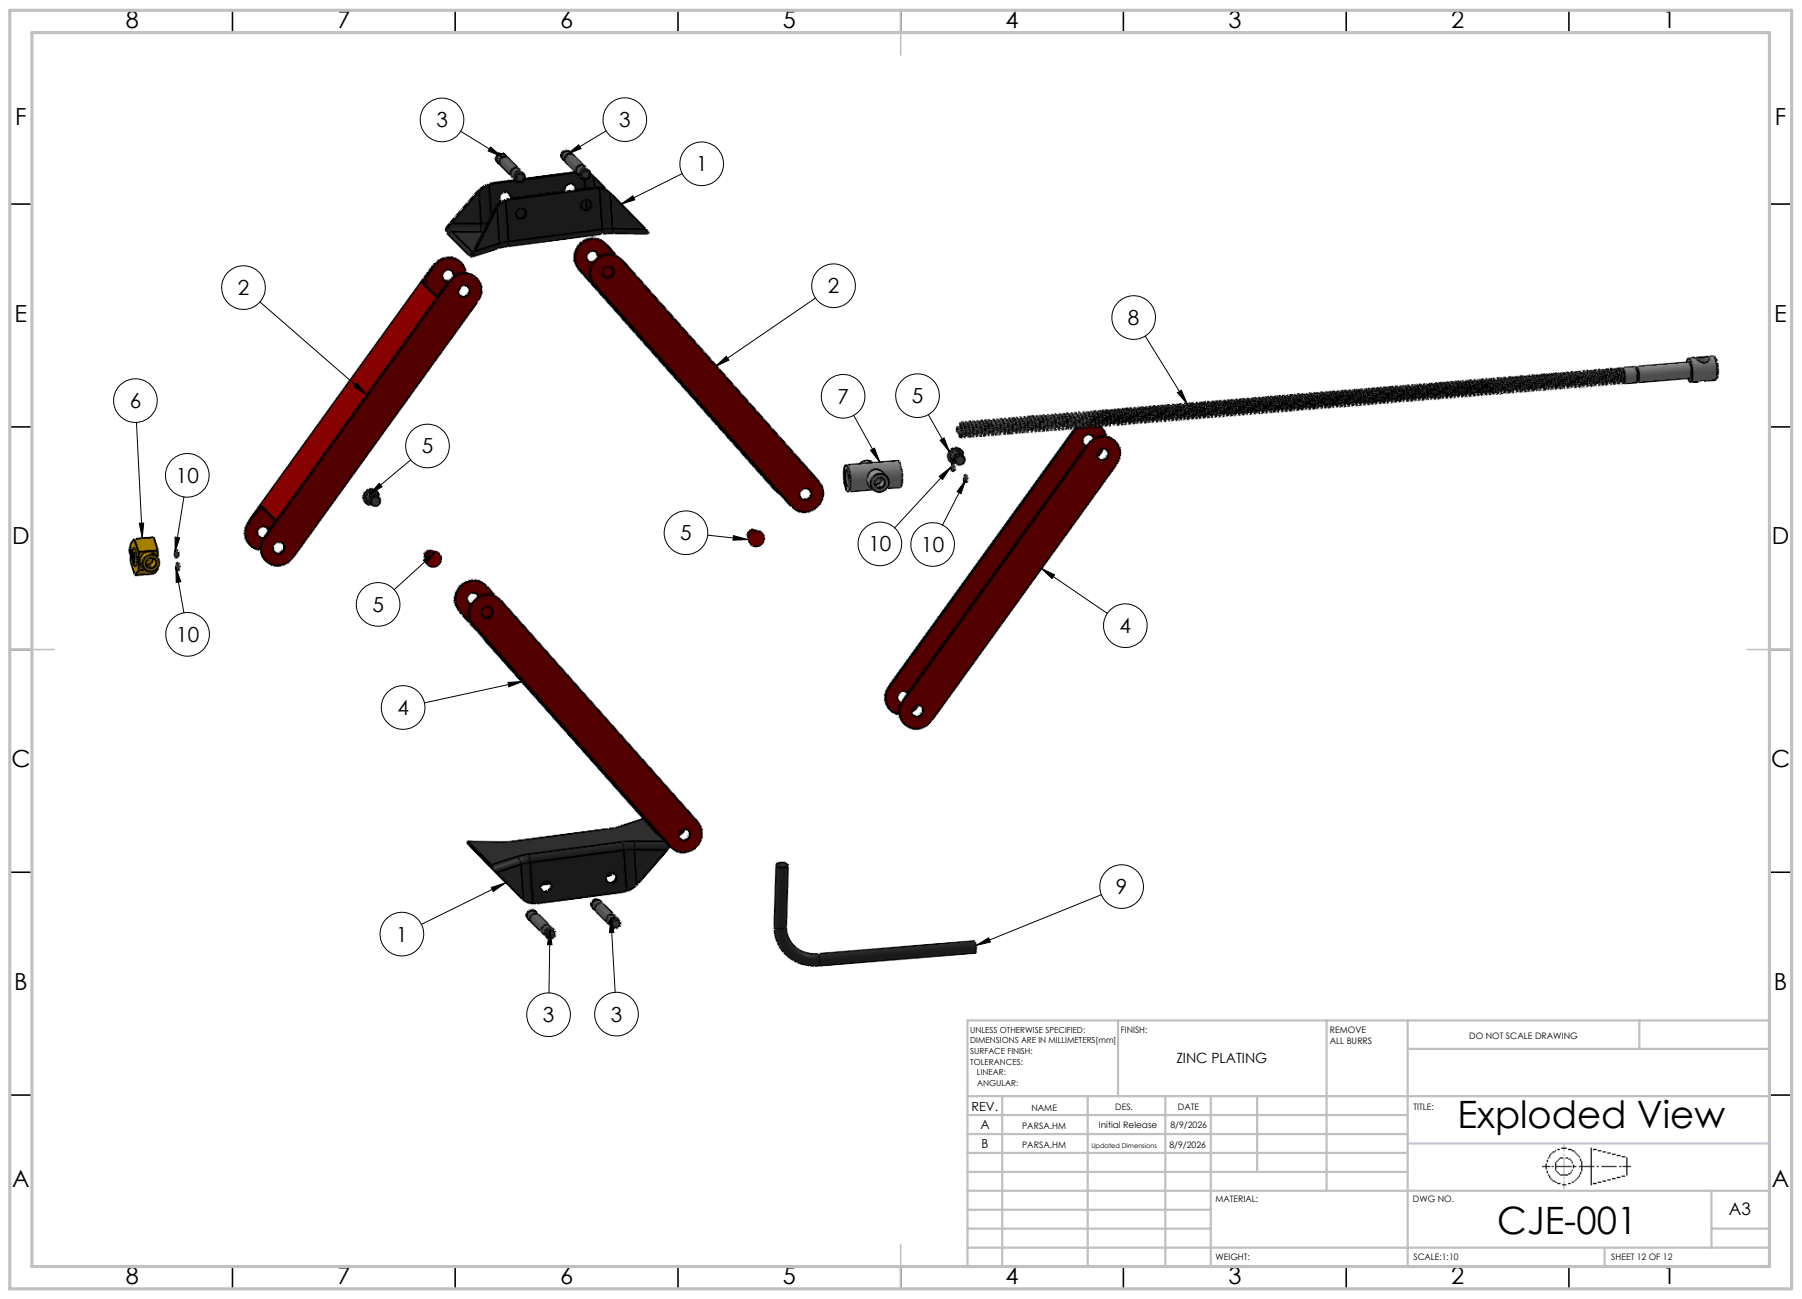
[picture p24: page 12]
ALL BURRS; SCALE:1:10; SHEET 12 OF 12; ZINC PLATING

UNLESS OTHERWISE SPECIFIED:
DIMENSIONS ARE IN MILLIMETERS[mm]
SURFACE FINISH:
TOLERANCES:
LINEAR:
ANGULAR:

DO NOT SCALE DRAWING

REV. | NAME | DES. | DATE | Exploded View TITLE:
A | PARSA.HM | Initial Release | 8/9/2026
B | PARSA.HM | Updated Dimensions | 8/9/2026
